SovGVD/esp32-legged-robots-core/src/web/docs/phone-status.png

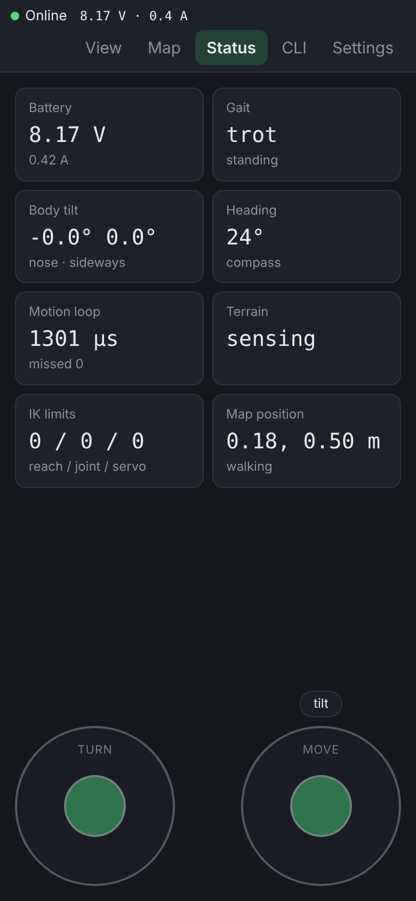
src/web/docs/phone-status.png
