SovGVD/esp32-legged-robots-core/cad/hexapod/hexapod.FCStd

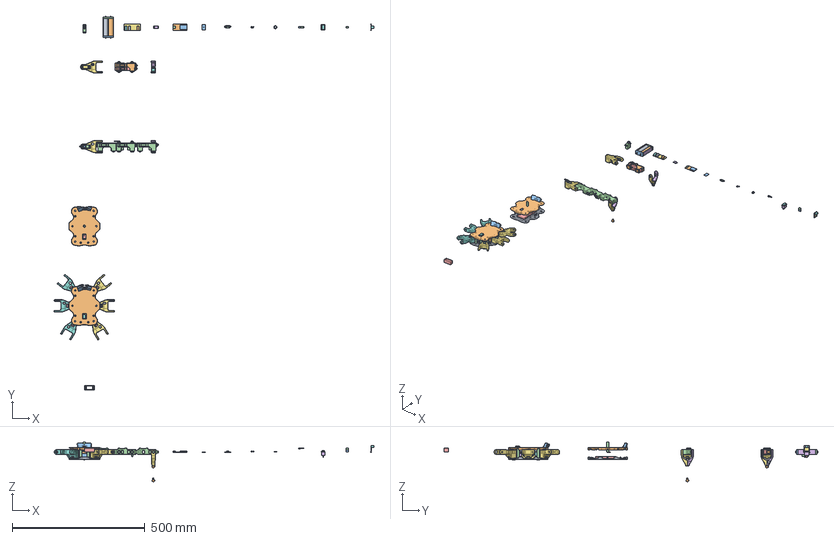
[picture p9: CAD file, 2026-11-13]
cad/hexapod/hexapod.FCStd
1204.8 x 1409.5 x 149.9 mm
_18650_pair_left x 2
_18650_pair_right x 2
_18650_pair_end_a x 2
_18650_pair_end_b x 2
_18650_pair_side_l x 2
_18650_pair_side_r x 2
_18650_pair_tab_al x 2
_18650_pair_tab_bl x 2
_18650_pair_tab_ar x 2
_18650_pair_tab_br x 2
GY91_pcb x 2
GY91_imu x 2
VL53L5CX_pcb x 3
VL53L5CX_ear_a x 3
VL53L5CX_hole_a x 3
VL53L5CX_ear_b x 3
VL53L5CX_hole_b x 3
VL53L5CX_pin_row x 3
VL53L5CX_cover_base x 3
VL53L5CX_sensor x 3
VL53L5CX_back_parts x 3
Microswitch_body x 2
Microswitch_button x 2
Microswitch_lead_a x 2
Microswitch_lead_b x 2
ESP32_devkit_pcb x 2
ESP32_devkit_module x 2
ESP32_devkit_usb x 2
Mini360_pcb
Mini360_components
PCA9685_pcb x 3
PCA9685_pins_1 x 3
PCA9685_pins_2 x 3
PCA9685_pins_3 x 3
PCA9685_tape_a x 3
PCA9685_mini_a x 3
PCA9685_comp_a x 3
PCA9685_tape_b x 3
PCA9685_mini_b x 3
PCA9685_comp_b x 3
PCA9685_tape_c x 3
PCA9685_mini_c x 3
PCA9685_comp_c x 3
MG90S_body x 11
MG90S_tabs x 11
MG90S_turret x 11
MG90S_shaft x 11
Bearing_ring x 11
Bearing_bore x 11
Bearing_body x 11
Horn_hub x 11
Horn_arm x 11
Horn_tip x 11
Rocker_body x 2
Rocker_bezel x 2
Rocker_rocker x 2
Rocker_pin_a x 2
Rocker_pin_b x 2
XT30_male x 2
XT30_female x 2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
