SovGVD/esp32-legged-robots-core/cad/hexapod/print/fit_test.stl

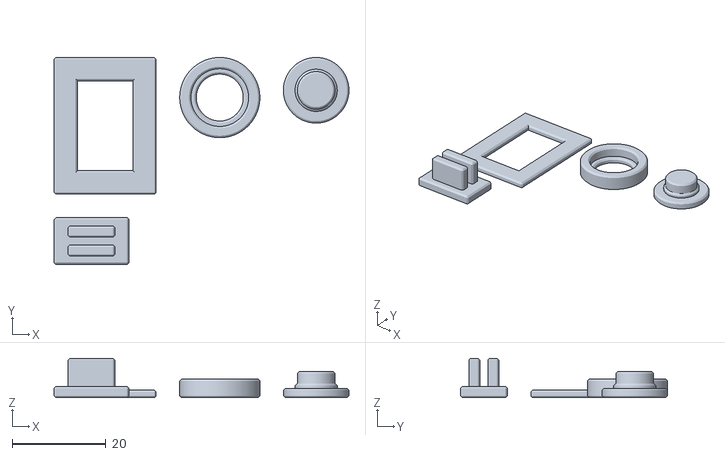
[picture p10: CAD file, 2026-11-06]
cad/hexapod/print/fit_test.stl
62.9 x 44.2 x 8.40
