SovGVD/esp32-legged-robots-core/sim/models/meshes/hexapod/coxa_L.stl

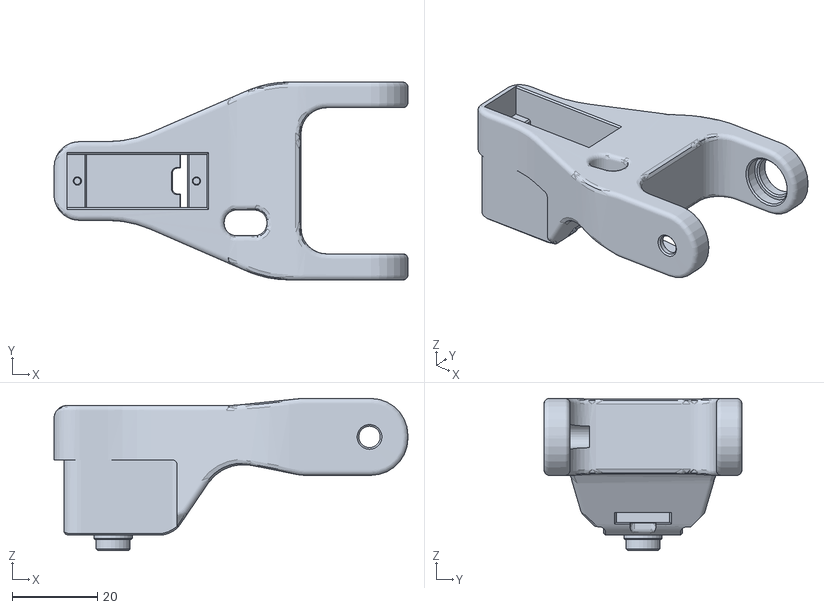
[picture p11: CAD file, 2026-11-13]
sim/models/meshes/hexapod/coxa_L.stl
82.8 x 46.3 x 35.6
