SovGVD/esp32-legged-robots-core/sim/models/meshes/leg_shoes_print_with_flexible.stl

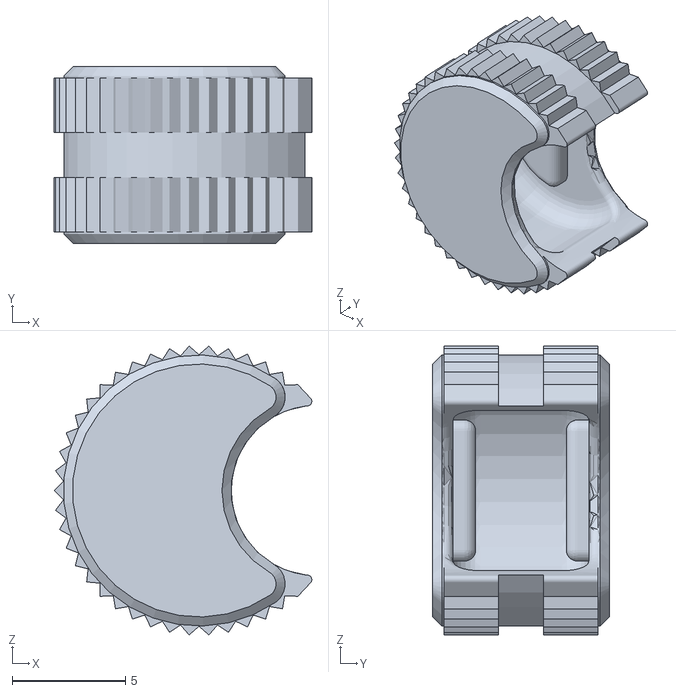
[picture p12: CAD file, 2026-11-02]
sim/models/meshes/leg_shoes_print_with_flexible.stl
11.4 x 7.80 x 12.8
