SovGVD/esp32-legged-robots-core/cad/hexapod/print/fit_test_servo.stl

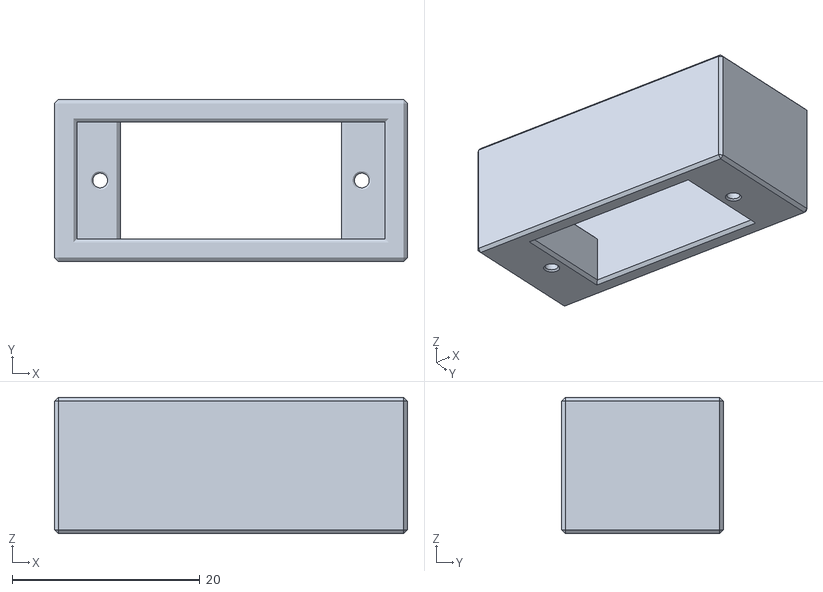
[picture p13: CAD file, 2026-11-06]
cad/hexapod/print/fit_test_servo.stl
37.6 x 17.2 x 14.5
