SovGVD/esp32-legged-robots-core/sim/models/meshes/body.stl

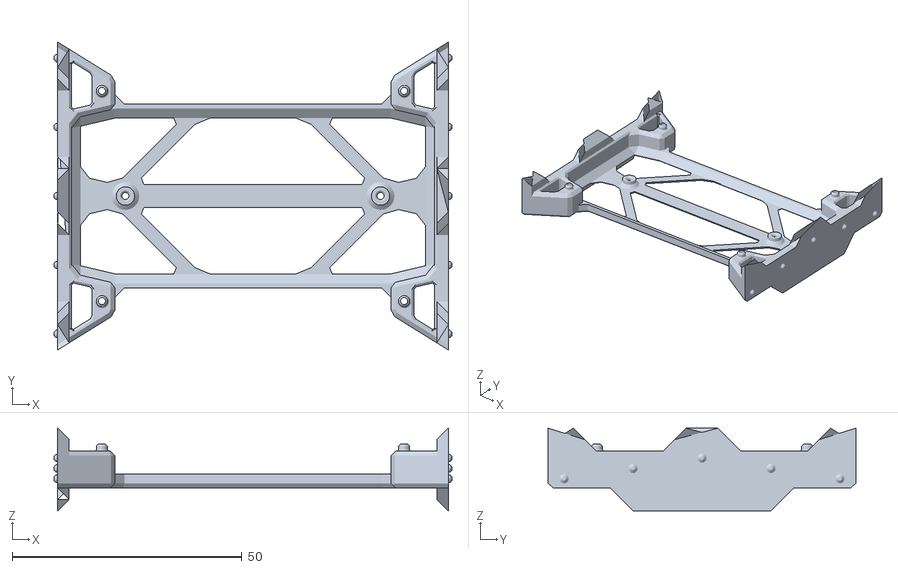
[picture p14: CAD file, 2026-11-02]
sim/models/meshes/body.stl
86.6 x 67.0 x 18.0
