SovGVD/esp32-legged-robots-core/sim/models/meshes/hexapod/torso_parts.stl

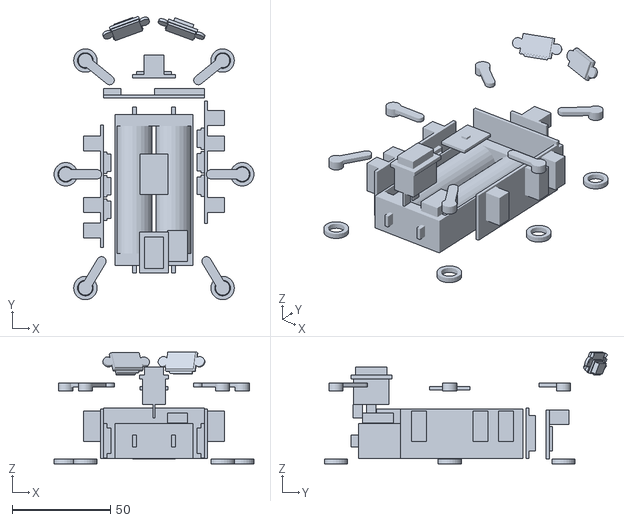
[picture p15: CAD file, 2026-11-13]
sim/models/meshes/hexapod/torso_parts.stl
102.0 x 144.5 x 57.0
