SovGVD/esp32-legged-robots-core/sim/models/meshes/shoulder_part2.stl

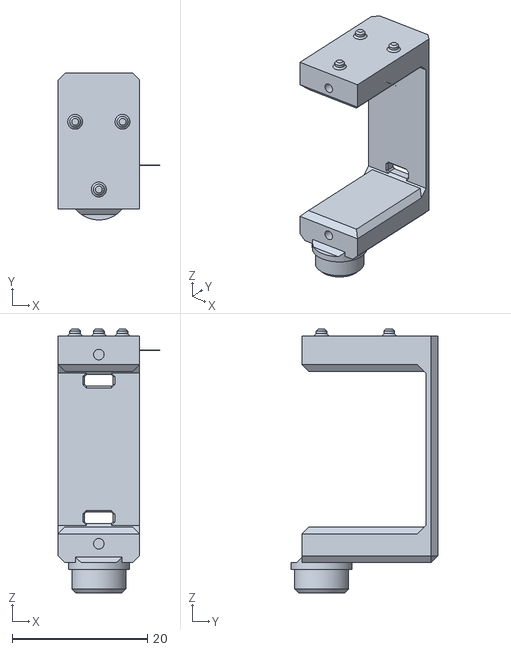
[picture p16: CAD file, 2026-11-02]
sim/models/meshes/shoulder_part2.stl
15.0 x 21.7 x 39.0
