SovGVD/esp32-legged-robots-core/sim/models/meshes/hexapod/coxa_servo_R.stl

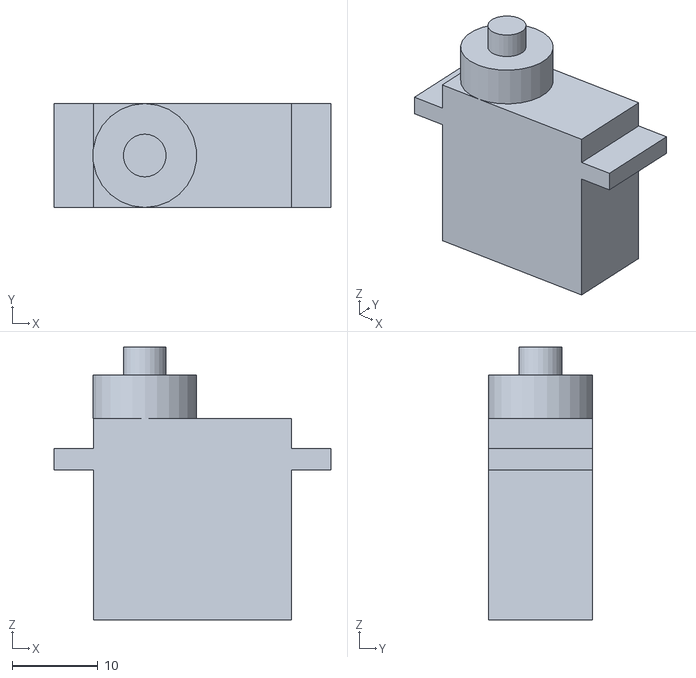
[picture p17: CAD file, 2026-11-13]
sim/models/meshes/hexapod/coxa_servo_R.stl
32.4 x 12.1 x 31.9
