SovGVD/esp32-legged-robots-core/sim/models/meshes/leg_top.stl

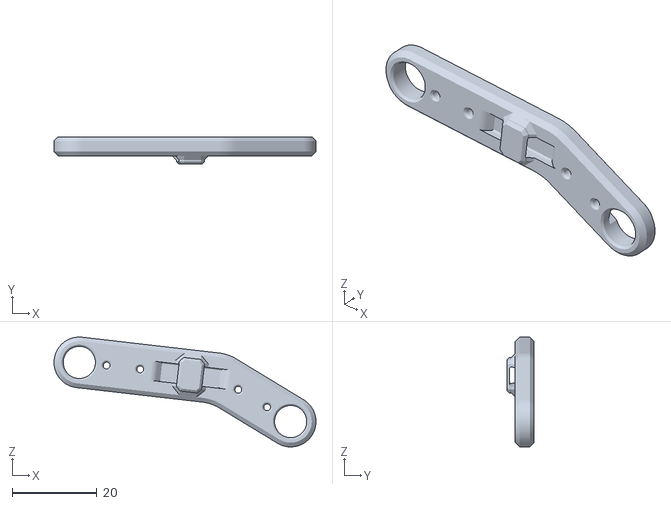
[picture p18: CAD file, 2026-11-02]
sim/models/meshes/leg_top.stl
62.0 x 6.50 x 26.0
