SovGVD/esp32-legged-robots-core/sim/models/meshes/hexapod/torso_top.stl

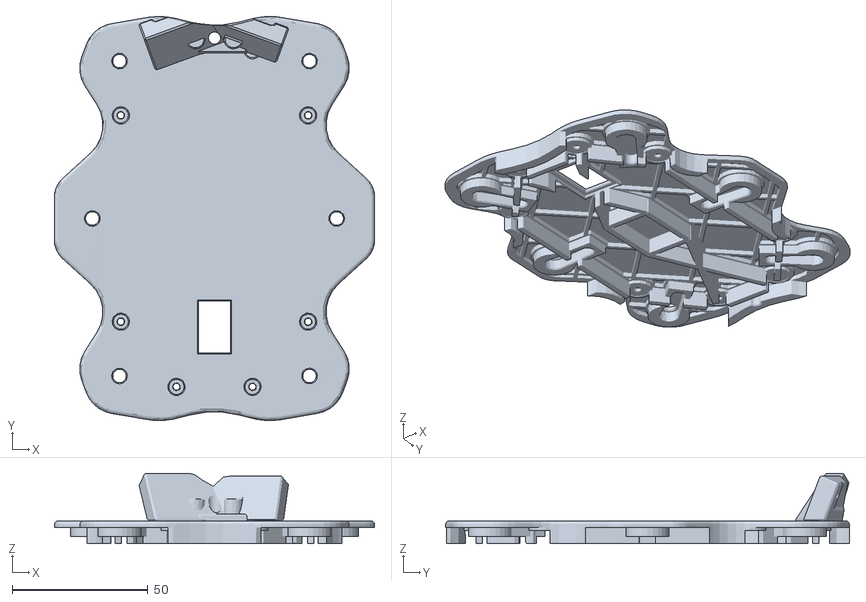
[picture p19: CAD file, 2026-11-13]
sim/models/meshes/hexapod/torso_top.stl
118.0 x 148.8 x 25.8
