SovGVD/esp32-legged-robots-core/sim/models/meshes/hexapod/torso_bottom.stl

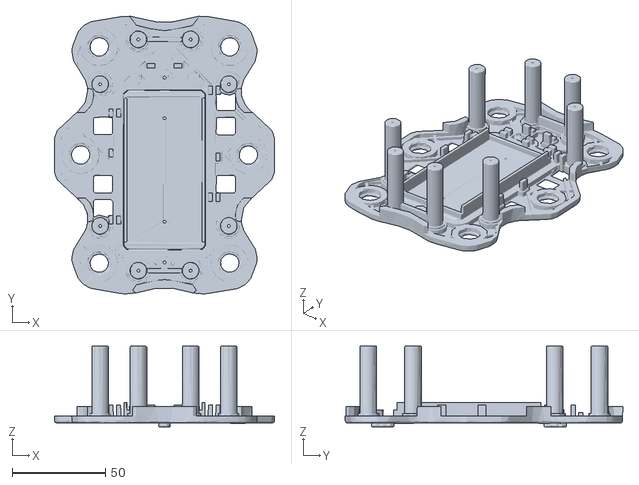
[picture p20: CAD file, 2026-11-13]
sim/models/meshes/hexapod/torso_bottom.stl
118.1 x 149.1 x 43.4
