SovGVD/esp32-legged-robots-core/sim/models/meshes/hexapod/femur_servos_R.stl

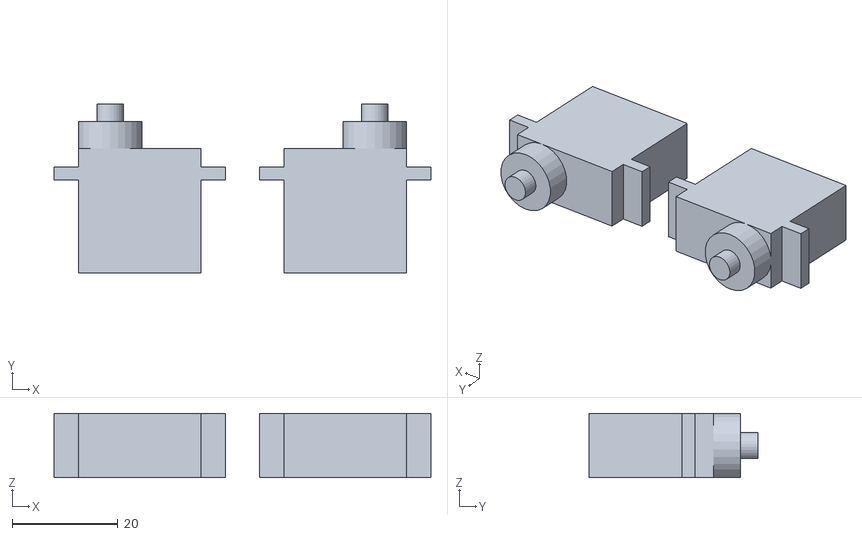
[picture p21: CAD file, 2026-11-13]
sim/models/meshes/hexapod/femur_servos_R.stl
71.2 x 31.9 x 12.1
