SovGVD/esp32-legged-robots-core/sim/models/meshes/hexapod/femur_L.stl

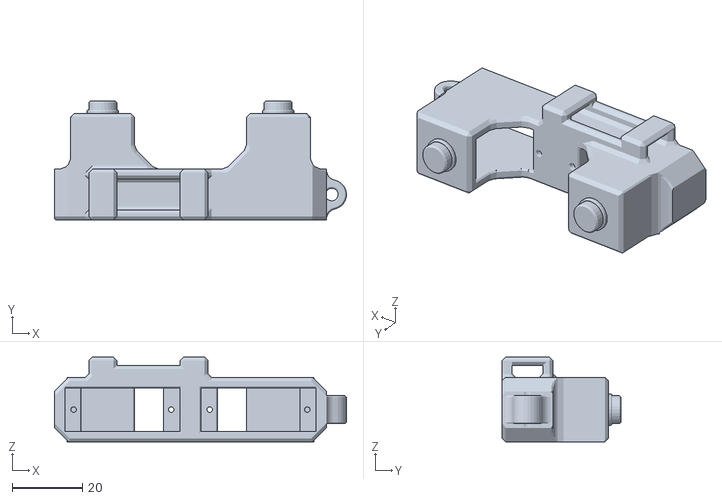
[picture p22: CAD file, 2026-11-13]
sim/models/meshes/hexapod/femur_L.stl
83.3 x 33.9 x 24.2
