SovGVD/esp32-legged-robots-core/sim/models/meshes/hexapod/tibia_L.stl

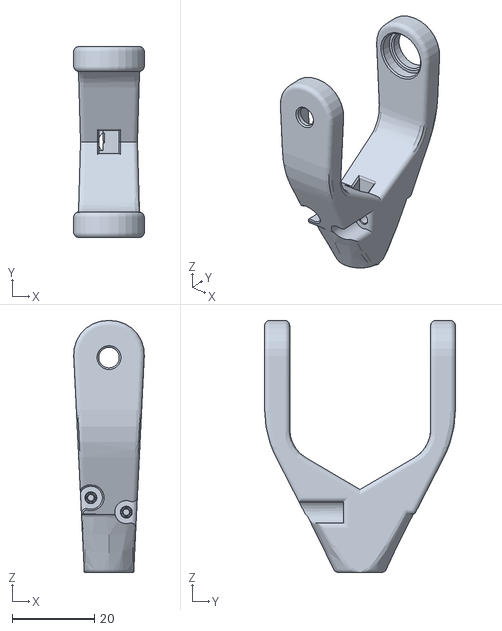
[picture p23: CAD file, 2026-11-13]
sim/models/meshes/hexapod/tibia_L.stl
17.2 x 46.3 x 61.2
