SovGVD/esp32-legged-robots-core/sim/models/meshes/hexapod/presser.stl

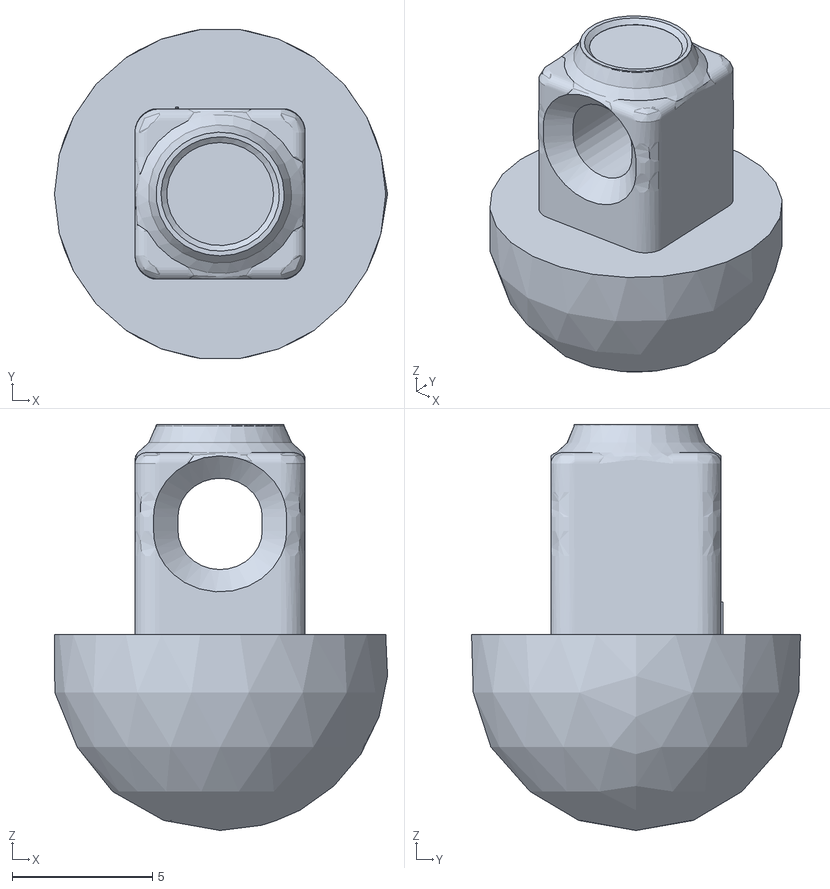
[picture p24: CAD file, 2026-11-08]
sim/models/meshes/hexapod/presser.stl
11.9 x 11.7 x 14.5
