SovGVD/esp32-legged-robots-core/sim/models/meshes/hexapod/coxa_gear.stl

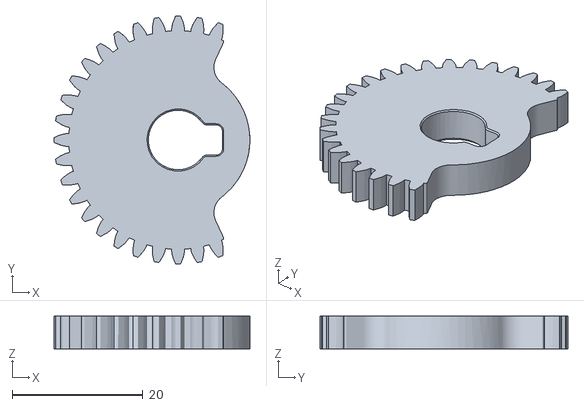
[picture p25: CAD file, 2026-11-03]
sim/models/meshes/hexapod/coxa_gear.stl
30.0 x 38.0 x 5.00
