SovGVD/esp32-legged-robots-core/(list of files, cad)

Other CAD files:
sim/models/meshes/hexapod/coxa_R.stl
sim/models/meshes/hexapod/coxa_servo_L.stl
sim/models/meshes/hexapod/femur_servos_L.stl
sim/models/meshes/hexapod/tibia_R.stl
sim/models/meshes/hexapod/femur_R.stl
