SovGVD/esp32-legged-robots-core/src/esp32-legged-robot/esp32-legged-robot.ino

#include <math.h>

#include "libraries/geometry/geometry.h"
#include "libraries/leg/leg.h"
#include "libraries/transition/transition.h"
#ifdef HORIZON_LEVEL
	#include "libraries/PID/AnglePID.h"
#endif
#include "def/def.h"
#include "def/cli.h"
#include "def/subscription.h"
#include "config.h"
#include "config_model.h"
#include "model/model.h"
#include "config_wifi.h"
#include "model/gait.h"
#include "model/settings.h"
#include "libraries/planner/planner.h"
#include "libraries/balance/balance.h"
#include "libraries/HAL_body/HAL_body.h"

#include <EEPROM.h>
#include <WiFi.h>
#include <WiFiClient.h>
#include <WiFiAP.h>
#include <DNSServer.h>
#include "ESPAsyncWebServer.h"
#include "web/index.html.gz.h"

#include <MPU9250_WE.h>
#include <Wire.h>

#include "libraries/PID/AnglePID.cpp"
#include "libraries/transition/transition.cpp"
#include "libraries/planner/planner.cpp"
#include "libraries/balance/balance.cpp"
#include "libraries/gait/gait.cpp"
#include "libraries/HAL_body/HAL_body.cpp"

#include "libraries/cliStream/cliStream.h"
#include "libraries/cliStream/cliStream.cpp"

#ifdef IGNORE_BROWNOUT_CONDITION
	#include "soc/soc.h"           // Disable brownour problems
	#include "soc/rtc_cntl_reg.h"  // Disable brownour problems
#endif

/**
 * Hardware libraries
 */
#if PWM_CONTROLLER_TYPE == PCA9685
  #include <Adafruit_PWMServoDriver.h>
#endif

#if PWM_CONTROLLER_TYPE == ESP32PWM
  #define USE_ESP32_TIMER_NO 0
  #include "ESP32_ISR_Servo.h"
#endif

#ifdef POWER_SENSOR
  float voltage_V = 0.0;
  float current_A = 0.0;

  #if POWER_SENSOR == INA219
    #include <INA219_WE.h>
    INA219_WE ina219;
  #endif
#endif

LR_angle IMU_DATA = {0, 0, 0};
MPU9250_WE IMU;

TaskHandle_t core0tasks;

#if PWM_CONTROLLER_TYPE == PCA9685
  Adafruit_PWMServoDriver pwm;
#endif

unsigned long currentTime;
unsigned long previousTime;
unsigned long loopTime;

unsigned long serviceCurrentTime;

unsigned long servicePreviousTime;
unsigned long serviceLoopTime;

unsigned long serviceFastPreviousTime;
unsigned long serviceFastLoopTime;

bool HALEnabled = true;

uint16_t servoPulse[LEG_NUM][LEG_DOF];

// Gait
uint16_t ticksPerGaitItem    = 0;
uint16_t ticksToNextGaitItem = 0;
uint8_t  currentGait         = 0;
uint8_t  nextGait            = 0;
double   gaitItemProgress    = 0;

transition bodyTransition;
transitionParameters bodyTransitionParams = {{0,0,0}, {0,0,0}, 0};

//Move
LR_moveVector vector = {
  {0, 0, 0},
  {0, 0, 0}
};

//Failsafe
bool FS_FAIL = false;
uint8_t FS_WS_count = 0;

// HAL
LR_figure body = {
  {  0,  0,  0},
  {  0,  0,  0}
};


LR_point bodyBalanceOffset = {0, 0, 0};

IK ikLeg(
	vector,
	body,
	bodyBalanceOffset,
	legs
);

gait gaitLeg(
	GAIT_CONFIG,
	legs
);


/* We need predict future position of legs/body */
planner walkPlanner(
	vector,
	body,
	legs
);

/* and balance it someway */
balance bodyBalance(
	body,
	legs
);

// IMU+PID
LR_angle imuCorrection = {0.0, 0.0, 0.0};
LR_angle imuTarget     = {0.0, 0.0, 0.0};

#ifdef HORIZON_LEVEL
	AnglePID imuCorrectionPID(IMU_DATA, imuTarget, imuCorrection, PID_LEVEL_P, PID_LEVEL_I, PID_LEVEL_D, -0.2, 0.2);
#endif

HAL_body bodyUpdate(vector, imuCorrection, body, legs);

// WebServer
IPAddress apIP(192,168,1,1);
IPAddress apGateway(192,168,1,1);
IPAddress apSubnet(255,255,255,0);
bool clientOnline = false;
AsyncWebSocketClient * wsclient;
int WiFiMode = AP_MODE;
IPAddress WiFiIP;
AsyncWebServer server(80);
AsyncWebSocket ws("/ws");
uint8_t telemetryPackage[P_TELEMETRY_LEN];

// DNS server
//const byte DNS_PORT = 53;
//DNSServer dnsServer;

#ifdef ESP32CAMERA
	#define CAMERAENABLED
	#include <esp32camera.h>
	esp32camera mainCamera;//(wsclient, ESP32CAMERA_FRAMESIZE, ESP32CAMERA_FPS, ESP32CAMERA_JPEG_QUALITY);
	bool mainCameraStream = false;
#endif

// CLI
cliStream *cliSerial;
cliStream cliStreamObj;

// Settings
modelSettings settings;

bool robotLoopReady   = false;
bool serviceLoopReady = false;
bool isHalDoReady     = false;

void robotSetup()
{
	if (!robotLoopReady) {
		Wire.begin(I2C_SDA, I2C_SCL);
		Wire.setClock(400000);
		vTaskDelay(100);

		initServo();

		initHAL();
		vTaskDelay(100);

		initGait();
		vTaskDelay(100);

		initIMU();
		vTaskDelay(100);

		initPowerSensor();
		vTaskDelay(100);

		robotLoopReady = true;
		Serial.println("MainSetup complete");
	}
}

void servicesSetup()
{
	if (!serviceLoopReady) {
		initServo();
		vTaskDelay(100);

		initCLI();
		vTaskDelay(100);
		
		initWiFi();
		vTaskDelay(100);

		initWebServer();
		vTaskDelay(100);

		#ifdef ESP32CAMERA
			mainCamera.setup(
				ESP32CAMERA_FRAMESIZE,
				ESP32CAMERA_FPS,
				ESP32CAMERA_JPEG_QUALITY
			);
		#endif

		Serial.println("ServicesSetup complete");
		serviceLoopReady = true;
	}
}

/**
 * Everything related to robot-only code: i2c, servos, imu, etc
 */
void robotLoop()
{
	currentTime = micros();
	if (currentTime - previousTime >= LOOP_TIME) {
		previousTime = currentTime;

		updateFailsafe();
		updatePower();  // TODO not so often!

		#ifdef HORIZON_LEVEL
			updateIMU();
			imuCorrectionPID.update();
		#endif
		if (!isHalDoReady) {
			updateGait();
			updateHAL();
			isHalDoReady = true;
		}
		#if DO_HAL_CORE == 1
			doHAL();
		#endif

		//CLI_doCommand();

		FS_WS_count++;

		loopTime = micros() - currentTime;
		if (loopTime > LOOP_TIME) {
			Serial.print("WARNING! Increase LOOP_TIME: ");
			Serial.println(loopTime);
		}
	}
}

/**
 * WiFi, WebServer, Cli and other bells and whistles
 */
void servicesLoop() {
	serviceCurrentTime = micros();

	#ifdef CAMERAENABLED
		if (clientOnline && mainCameraStream) {
			mainCamera.processFrame();
		}
	#endif
	
	/**
	 * @TODO this to actually kind of wrong as first IF will slow down second IF and so on =(
	 */

	if (serviceCurrentTime - serviceFastPreviousTime >= LOOP_TIME) {
		serviceFastPreviousTime = serviceCurrentTime;

		#if DO_HAL_CORE == 0
			doHAL();
		#endif

		serviceFastLoopTime = micros() - serviceCurrentTime;
		if (serviceFastLoopTime > LOOP_TIME) {
			Serial.print("WARNING! Increase SERVICE_FAST_LOOP_TIME: ");
			Serial.println(serviceFastLoopTime);
		}
	}

	if (serviceCurrentTime - servicePreviousTime >= SERVICE_LOOP_TIME) {
		servicePreviousTime = serviceCurrentTime;

		updateCLI();
		CLI_doCommand();

		serviceLoopTime = micros() - serviceCurrentTime;
		if (serviceLoopTime > SERVICE_LOOP_TIME) {
			Serial.print("WARNING! Increase SERVICE_LOOP_TIME: ");
			Serial.println(serviceLoopTime);
		}
	}
}

/**
   TODO
    - calculate center of mass and use it for balance
*/

void setup()
{
	#ifdef IGNORE_BROWNOUT_CONDITION
		WRITE_PERI_REG(RTC_CNTL_BROWN_OUT_REG, 0); //disable brownout detector
	#endif
	Serial.begin(SERIAL_BAUD);
	cliStreamObj.setStreamPrefix(P_CLI);
	cliStreamObj.setClient(wsclient);
	cliSerial = &cliStreamObj;

	initSettings();
	vTaskDelay(100);

	robotSetup();
	vTaskDelay(10);

	xTaskCreatePinnedToCore(
		core0loop,      /* Task function. */
		"core0loop",    /* name of task. */
		100000,         /* Stack size of task */
		NULL,           /* parameter of the task */
		0,              /* priority of the task */
		&core0tasks,    /* Task handle to keep track of created task */
		0);             /* pin task to core 0 */
}

/**
 * Core 1
 */
void loop()
{
	if(robotLoopReady && serviceLoopReady) {
		//dnsServer.processNextRequest();
		robotLoop();
	}
}

/**
 * Core 0
 */
void core0loop(void * pvParameters) {
	if (robotLoopReady) {
		servicesSetup();
	}

	while(robotLoopReady && serviceLoopReady) {
		servicesLoop();
		vTaskDelay(1);
	}

	vTaskDelay(100);
}
