SovGVD/esp32-legged-robots-core/cad/hexapod/build_coxa.py

"""The coxa link: one print carrying the coxa servo. A real shape, not stacked boxes: from
above a horseshoe, round around the coxa axis and curving out to the fork around the
femur; from the side an arch under it. The servo sits in a pocket cut into that.

The servo's horn fixes to the body's top plate. A floor under the servo carries a shaft
that runs in the bearing in the body's bottom plate. Horns are glued into their pockets.
In the fork the femur servo's horn sits in the +Y arm and the femur's shaft runs in a bearing in the -Y arm. The cables of
the femur's 2 servos and the foot switch go down a hole through the coxa, beside the servo, to where the coxa servo's own
cable comes out under the coxa (the servo's pocket opens through the arch there); the 4 are zip-tied together there.

The -Y (bearing) side is a separate print, screwed on with 2 stock MG90S screws like the
tibia halves: a one-piece fork can't take the femur, whose spline and shaft both point
outward. It comes off on a plane next to the servo (coxa_cut_y) from coxa_cut_x out, a
plate printed on its outer face; the coxa prints on its +Y face. From above the coxa is symmetric: the bearing
side curves out like the horn side, the plate continuing the curve. Underneath it tapers like a keel. The screw heads sit 2 mm over the joint face. Assembly: glue the
horn into the +Y arm, put the bearing on the femur's shaft in the loose side, push the
femur's servo onto the horn, then screw the side on.

  Coxa_Body  the coxa with the servo and the +Y (horn) arm
  Coxa_Arm   the -Y (bearing) side
  Coxa_Main  both together, for the checks, the body and the FEA

Right leg; Coxa_Main_L is the left leg's. Leg frame: origin on the coxa axis at femur axis
height, +X out along the link, Z up. Sizes come from Params when this script runs:
re-run it after changing them.
"""
import os
import runpy

import FreeCAD as App
import Part

HERE = os.path.dirname(os.path.abspath(__file__))
common = runpy.run_path(os.path.join(HERE, "common.py"))
doc = common["get_doc"]()
PLA = (0.88, 0.63, 0.11)
SERVO_ROT = App.Rotation(App.Vector(0, 0, 1), 90)       # servo Y to -X: its body runs toward +X, shaft up
HORN_IN = App.Rotation(App.Vector(0, 0, 1), 180)        # coxa horn arm toward the body
KNEE = App.Rotation(App.Matrix(0, 1, 0, 0,  0, 0, 1, 0,  1, 0, 0, 0,  0, 0, 0, 1))
FEMUR_HORN = KNEE.multiply(App.Rotation(App.Vector(0, 0, 1), -90))
HIP_SERVO = KNEE.multiply(App.Rotation(App.Vector(0, 0, 1), 180))
BEARING_ALONG_Y = App.Rotation(App.Vector(1, 0, 0), -90)
S = doc.getObject("Params")


def v(alias):
    x = S.get(alias)
    return float(getattr(x, "Value", x))


common["remove_built"](doc, ("CoxaCheck", "CoxaPrim", "Coxa"))
part = doc.addObject("App::Part", "Coxa")
part.setExpression("Placement.Base.y", "Params.catalog_row2_y")
check = doc.addObject("App::Part", "Coxa_Check")
check.setExpression("Placement.Base.y", "Params.catalog_row2_y * 3")
prism, block, rod = common["prism"], common["block"], common["rod"]

fl = v("coxa_len")
arm_r = v("coxa_arm_w") / 2
end_x = fl + arm_r
a_y0, a_y1 = v("coxa_arm_a_y0"), v("coxa_arm_a_y1")
b_y1 = v("coxa_arm_b_y1")
b_y0 = v("coxa_arm_b_y0")
rear, side_y, rear_r = v("coxa_tail_x"), v("coxa_side_y"), v("coxa_rear_corner_r")
waist_x, waist_r = v("coxa_waist_x"), v("coxa_waist_r")
fork_x = v("coxa_cross_x1")
fork_r = v("coxa_fork_r")
z0, z1 = v("coxa_plate_z0"), v("coxa_plate_z1")
floor_z0 = v("coxa_floor_z0")
floor_in = floor_z0 + v("coxa_floor_t")
seat = v("coxa_seat_z")

# the horseshoe from above: around the servo only a wall wide (the rest of the coxa takes the load)
straight = v("coxa_straight_x")
cut_x, cut_y = v("coxa_cut_x"), v("coxa_cut_y")
# symmetric from above: the bearing side curves out to the fork's width like the horn side, by waist_x
above = prism([(-rear, side_y, rear_r), (straight, side_y, 25), (waist_x, a_y1, 25), (end_x, a_y1, 0), (end_x, a_y0, 0), (fork_x, a_y0, fork_r),
               (fork_x, b_y1, fork_r), (end_x, b_y1, 0), (end_x, b_y0, 0), (waist_x, b_y0, 25), (straight, -side_y, 25), (-rear, -side_y, rear_r)],
              "xy", floor_z0 - 1, arm_r + 1)
# the arch from the side, with a round end around the femur axis
side = prism([(-rear, z1, 3), (v("coxa_top_x"), z1, 20), (fork_x, arm_r, 20), (end_x, arm_r, arm_r), (end_x, -arm_r, arm_r),
              (fork_x, -arm_r, 12), (v("coxa_arch_x1"), z0, 10), (v("coxa_arch_x0"), floor_z0, 6), (-rear, floor_z0, 4)],
             "xz", b_y0 - 1, a_y1 + 1)
shape = above.common(side).removeSplitter()

# ------------------------------------------------------------ cut the pockets into it
fit = v("mg90_fit")
hw = v("mg90_body_w") / 2 + v("mg90_fit_w")
near = v("mg90_shaft_end") + fit
far = v("mg90_body_len") - v("mg90_shaft_end") + fit
tab_near = v("mg90_tab_near") + fit
tab_far = v("mg90_tab_far") + fit
tip_w = v("horn_tip_w")
pocket = v("horn_hub_h") + v("horn_fit")      # the horn plus a little room for glue
arm = v("horn_reach") - tip_w / 2
through = a_y1 - a_y0 + 1
horn_way = pocket + 0.3                       # the horn's way in, in front of its pocket
cuts = [
    block(-near, far, -hw, hw, floor_in, z1 + 1),                # the servo's body, down to the floor
    # the servo's cable leaves the bottom of its far end: a slot through the floor there takes it down and out
    # under the coxa, so it isn't trapped under the servo (as in the femur, print 1)
    block(far - v("coxa_cable_slot_x"), far, -v("coxa_cable_slot_w") / 2, v("coxa_cable_slot_w") / 2, floor_z0 - 10, floor_in + 1),
    block(-tab_near, tab_far, -hw, hw, seat, z1 + 1),            # its tabs
    rod(v("mg90_screw_pilot_d"), v("coxa_plate_floor") + 1, (-v("mg90_hole_near"), 0, z0 - 1), "z"),
    rod(v("mg90_screw_pilot_d"), v("coxa_plate_floor") + 1, (v("mg90_hole_far"), 0, z0 - 1), "z"),
    # the femur servo's horn, its arm toward the coxa axis
    common["horn_pocket"](v("horn_pocket_d") / 2, v("horn_pocket_w") / 2, arm, pocket, (fl, a_y0, 0), (-1, 0, 0), (0, 1, 0)),
    # its way in: the arm's tip lies under the fork's crotch, so the same outline goes one layer deeper into
    # the crotch. The horn slides in from the open end of the fork, then sideways into its pocket.
    common["horn_pocket"](v("horn_pocket_d") / 2, v("horn_pocket_w") / 2, arm, horn_way + 0.01, (fl, a_y0 - horn_way, 0),
                          (-1, 0, 0), (0, 1, 0)),
    rod(5.0, through, (fl, a_y0, 0), "y"),
    # the femur's bearing
    rod(v("bearing_seat_d"), b_y1 - v("tib_bear_seat_end") + 1, (fl, v("tib_bear_seat_end"), 0), "y"),
    rod(v("bearing_push_d"), v("tib_bear_roof") + 1, (fl, b_y0 - 1, 0), "y"),
]
# the femur's cables go down a hole through the coxa, beside the servo, to the coxa servo's cable under it
h_x0, h_x1 = v("coxa_hole_x0"), v("coxa_hole_x1")
h_r = v("coxa_hole_w") / 2
h_y = v("coxa_hole_y")
hole = prism([(h_x0, h_y - h_r, h_r - 0.01), (h_x1, h_y - h_r, h_r - 0.01), (h_x1, h_y + h_r, h_r - 0.01), (h_x0, h_y + h_r, h_r - 0.01)],
             "xy", z0 - 5, arm_r + 2)
cuts.append(hole)
# solid otherwise: the slicer's infill fills it, with no overhangs inside to support
# (the -Y side is solid behind the bearing arm's joint face this far, for its screws)
j_y = v("coxa_joint_y")
# under the plate the rear is narrower: it swings next to the board's pins
skirt = block(-rear - 1, v("coxa_arch_x0") + 1, -rear - 8, rear + 8, floor_z0 - 2, z0).cut(
    prism([(-v("coxa_skirt_x"), 9.2, 4), (v("coxa_arch_x0") + 2, 9.2, 0), (v("coxa_arch_x0") + 2, -9.2, 0), (-v("coxa_skirt_x"), -9.2, 4)], "xy", floor_z0 - 3, z0 + 1))
cuts.append(skirt)
# seen from the fork end the underside tapers like a keel: from the fork arms' outer faces at z ~-9 down to
# the floor's width at its bottom, both sides alike (print 1 feedback: the flare's low part looked like a triangle)
k_top, k_bot = v("coxa_keel_top_z"), floor_z0
k_y1 = max(abs(a_y1), abs(b_y0))
for sgn in (1, -1):
    cuts.append(prism([(sgn * k_y1, k_top, 0), (sgn * side_y, k_bot, 0), (sgn * side_y, k_bot - 20, 0), (sgn * (k_y1 + 20), k_bot - 20, 0),
                       (sgn * (k_y1 + 20), k_top, 0)], "yz", -rear - 2, end_x + 2))
shape = shape.cut(Part.makeCompound(cuts)).removeSplitter()
# the shaft under the floor, on its spacer
shaft = rod(v("fem_boss_d"), v("fem_boss_h"), (0, 0, floor_z0 - v("fem_boss_h")), "z").fuse(
    rod(v("coxa_shaft_d"), v("fem_shaft_len"), (0, 0, floor_z0 - v("fem_boss_h") - v("fem_shaft_len")), "z"))
shape = shape.fuse(shaft).removeSplitter()
print("raw solids", len(shape.Solids), shape.isValid())

# ------------------------------------------------------------ round the outer edges


def keep_sharp(e):
    bb = e.BoundBox
    servo = abs(bb.YMin) <= hw + 0.2 and abs(bb.YMax) <= hw + 0.2 and bb.ZMin >= floor_in - 0.2 and bb.XMin >= -tab_near - 0.2 and bb.XMax <= tab_far + 0.2
    horn = bb.YMin >= a_y0 - horn_way - 0.1 and bb.YMax <= a_y0 + pocket + 0.1 and bb.XMin >= fl - v("horn_reach") - 0.2
    bearing = bb.YMax < b_y1 + 0.1 and abs(bb.XMin - fl) <= 7 and abs(bb.XMax - fl) <= 7 and abs(bb.ZMin) <= 7 and abs(bb.ZMax) <= 7
    in_hole = bb.XMin >= h_x0 - 0.2 and bb.XMax <= h_x1 + 0.2 and bb.YMin >= h_y - h_r - 0.2 and bb.YMax <= h_y + h_r + 0.2
    small_round = e.Curve.TypeId == "Part::GeomCircle" and e.Curve.Radius < 5 and not in_hole
    shaft_area = bb.ZMax <= floor_z0 + 0.1 and abs(bb.XMin) < 6 and abs(bb.XMax) < 6
    return servo or horn or bearing or small_round or shaft_area


# the top edges along both sides' curves get a bigger round than the rest of the outline (the kernel
# refuses large ones there: they run into the rising top past x 26)
flare_edges = [e for e in shape.Edges if e.BoundBox.ZLength < 0.01 and abs(e.BoundBox.ZMin - z1) < 0.01 and (e.BoundBox.YMax < -9.0 or e.BoundBox.YMin > 9.0)]
for r_ in (v("coxa_flare_edge_r"), 2.0, 1.5):
    try:
        trial = shape.makeFillet(r_, flare_edges)
        if trial.isValid() and len(trial.Solids) == 1 and 0.97 * shape.Volume < trial.Volume <= shape.Volume:
            print("side top edges rounded r %.1f (%d edges)" % (r_, len(flare_edges)))
            shape = trial
            break
    except Exception:
        print("side top edges: r %.1f refused" % r_)
main_shape = common["smooth"](shape, v("coxa_edge_r"), keep_sharp)
# ------------------------------------------------------------ the bearing side comes off
# on the plane cut_y, from cut_x out: a plate with the bearing arm, printed on its outer face (flat from waist_x
# out; nearer the coxa it follows the outline's curve up off the bed). The coxa prints on its +Y (horn arm) face
side_box = block(cut_x, end_x + 5, b_y0 - 5, cut_y, -100, 100)
arm_shape = main_shape.common(side_box).removeSplitter()
body_shape = main_shape.cut(side_box).removeSplitter()
head_y = v("coxa_screw_head_y")                      # the head seats this far from the joint face
for x, z in ((v("coxa_screw_a_x"), v("coxa_screw_a_z")), (v("coxa_screw_b_x"), v("coxa_screw_b_z"))):
    arm_shape = arm_shape.cut(Part.makeCompound([
        rod(v("tib_screw_clear"), cut_y - b_y0 + 2, (x, b_y0 - 1, z), "y"),
        rod(v("tib_screw_head_d"), (cut_y - head_y) - b_y0 + 1, (x, b_y0 - 1, z), "y")]))
    body_shape = body_shape.cut(rod(v("tib_screw_d"), j_y - cut_y + 1, (x, cut_y - 1, z), "y"))


def joint_face(e):
    """Edges in the joint stay sharp (the pieces meet there), except the screw holes' mouths."""
    bb = e.BoundBox
    try:
        small_hole = e.Curve.TypeId == "Part::GeomCircle" and 2 * e.Curve.Radius <= v("lead_small_d") + 1e-6
    except Exception:
        small_hole = False
    on_y = bb.YLength < 1e-4 and abs(bb.YMin - cut_y) < 1e-4
    on_x = bb.XLength < 1e-4 and abs(bb.XMin - cut_x) < 1e-4 and bb.YMax <= cut_y + 1e-4
    return (on_y or on_x) and not small_hole


def shaft_or_joint(e):
    # the shaft and its spacer under the floor stay as they are: the spacer presses on the bearing's inner ring
    c = e.BoundBox.Center
    shaft = (c.x ** 2 + c.y ** 2) ** 0.5 <= v("fem_boss_d") / 2 + 0.2 and e.BoundBox.ZMax <= floor_z0 + 0.01
    return shaft or joint_face(e)


body_shape = common["lead_ins"](body_shape, v("lead_small"), v("lead_big"), v("lead_small_d"), shaft_or_joint)
arm_shape = common["lead_ins"](arm_shape, v("lead_small"), v("lead_big"), v("lead_small_d"), joint_face)
# the shaft's own chamfers: a lead-in on its tip (into the bearing), and only a small one on the spacer's
# outer edge, which must still bear on the inner ring (8 to 9 mm across, the ring's own bore chamfer eats the inner part)
spacer_z = floor_z0 - v("fem_boss_h")
tip_z = spacer_z - v("fem_shaft_len")


def ring_edge(r, z):
    for e in body_shape.Edges:
        if abs(e.BoundBox.ZMin - z) > 1e-4 or abs(e.BoundBox.ZMax - z) > 1e-4:
            continue
        try:
            c = e.Curve
            if c.TypeId == "Part::GeomCircle" and abs(c.Radius - r) < 1e-4 and abs(c.Center.x) < 1e-4 and abs(c.Center.y) < 1e-4:
                return e
        except Exception:                       # edges without a plain curve
            continue
    raise RuntimeError("no shaft edge r %.2f at z %.2f" % (r, z))


body_shape = body_shape.makeChamfer(v("lead_big"), [ring_edge(v("coxa_shaft_d") / 2, tip_z)])
body_shape = body_shape.makeChamfer(v("lead_small"), [ring_edge(v("fem_boss_d") / 2, spacer_z)])
# alignment pins on the bearing side's joint face, holes for them in the coxa: the bearing side prints on
# its outer face, pins up
arm_shape, body_shape, pin_sites = common["align_pins"](
    arm_shape, body_shape, [(v("coxa_pin_a_x"), v("coxa_pin_a_z")), (v("coxa_pin_b_x"), v("coxa_pin_b_z"))], cut_y, 1,
    v("align_pin_d"), v("align_pin_h"), v("align_hole_d"), v("align_hole_h"), v("align_hole_ch"), v("align_pin_ch"))
print("alignment pins, (hole site solid, pin base solid) each, 1.0 is good: %s" % pin_sites)
body = common["as_part"](doc, part, "Coxa_Body", body_shape, PLA)
arm_part = common["as_part"](doc, part, "Coxa_Arm", arm_shape, (0.95, 0.75, 0.3))
common["add_mirror"](doc, part, body, PLA)
common["add_mirror"](doc, part, arm_part, (0.95, 0.75, 0.3))
main_shape = Part.makeCompound([body_shape, arm_shape])
main = common["as_part"](doc, part, "Coxa_Main", main_shape, PLA)
common["add_mirror"](doc, part, main, PLA)
common["save"](doc)


def link(name, target, base, rot=None):
    obj = doc.addObject("App::Link", "CoxaCheck_" + name)
    check.addObject(obj)
    obj.LinkedObject = target
    obj.Placement = App.Placement(App.Vector(*base), rot or App.Rotation())
    return obj


bz = floor_z0 - v("fem_boss_h") - v("bearing_t")
link("main", main, (0, 0, 0))
link("servo", doc.getObject("Dummy_MG90S"), (0, 0, seat), SERVO_ROT)
link("horn", doc.getObject("Dummy_Horn"), (0, 0, seat), HORN_IN)
link("bearing", doc.getObject("Dummy_Bearing"), (0, 0, bz))
link("femur", doc.getObject("Femur_Main"), (fl, 0, 0))
common["save"](doc)

solids_of, clash = common["solids_of"], common["clash"]
SERVO = ["MG90S_body", "MG90S_tabs", "MG90S_turret", "MG90S_shaft"]
HORN = ["Horn_hub", "Horn_arm", "Horn_tip"]
Pl = lambda x, y, z, rot=None: App.Placement(App.Vector(x, y, z), rot or App.Rotation())
main_s = solids_of(doc, ["Coxa_Main"])
s_y = v("joint_seat_y")
b_y = v("fem_floor_y0") - v("fem_boss_h") - v("bearing_t")
bb = main_shape.BoundBox
print("coxa %.1f g solid (body %.1f, arm %.1f); valid %s %s; solids %d %d; x %.1f to %.1f, y %.1f to %.1f, z %.1f to %.1f" % (
    main_shape.Volume / 1000 * v("pla_density"), body_shape.Volume / 1000 * v("pla_density"), arm_shape.Volume / 1000 * v("pla_density"),
    body_shape.isValid(), arm_shape.isValid(), len(body_shape.Solids), len(arm_shape.Solids), bb.XMin, bb.XMax, bb.YMin, bb.YMax, bb.ZMin, bb.ZMax))
print("overlap mm3: body and arm %.3f" % clash(body_shape.Solids, arm_shape.Solids))
print("overlap mm3: coxa servo %.3f, coxa horn %.3f, coxa bearing %.3f, femur horn %.3f, femur bearing %.3f" % (
    clash(solids_of(doc, SERVO, Pl(0, 0, seat, SERVO_ROT)), main_s), clash(solids_of(doc, HORN, Pl(0, 0, seat, HORN_IN)), main_s),
    clash(solids_of(doc, ["Bearing_body"], Pl(0, 0, bz)), main_s),
    clash(solids_of(doc, HORN, Pl(fl, s_y, 0, FEMUR_HORN)), main_s),
    clash(solids_of(doc, ["Bearing_body"], Pl(fl, b_y, 0, BEARING_ALONG_Y)), main_s)))
fixed = {"coxa": main_s, "coxa servo": solids_of(doc, SERVO, Pl(0, 0, seat, SERVO_ROT))}
hits = {}
for deg in range(-90, 91, 10):
    swing = Pl(fl, 0, 0, App.Rotation(App.Vector(0, 1, 0), deg))
    moved = {"femur": solids_of(doc, ["Femur_Main"], swing),
             "hip servo": solids_of(doc, SERVO, swing.multiply(Pl(0, s_y, 0, HIP_SERVO))),
             "knee servo": solids_of(doc, SERVO, swing.multiply(Pl(v("femur_len"), s_y, 0, KNEE)))}
    for mname, group in moved.items():
        for fname, f in fixed.items():
            x = clash(group, f)
            if x > 0.001:
                hits.setdefault((mname, fname), []).append(deg)
print("femur sweep, angles that collide: %s" % (hits or "none"))
