SovGVD/esp32-legged-robots-core/src/esp32-legged-robot/model/settings.h

#ifndef MODEL_SETTINGS_H
#define MODEL_SETTINGS_H

#if ROBOT_MODEL == MODEL_DOG
  #include "dog/settings.h"
#endif

#if ROBOT_MODEL == MODEL_BIPED
  #include "biped/settings.h"
#endif

#if ROBOT_MODEL == MODEL_TANK
  #include "tank/settings.h"
#endif

#if ROBOT_MODEL == MODEL_HEXAPOD
  #include "hexapod/settings.h"
#endif

#endif
