SovGVD/esp32-legged-robots-core/src/esp32-legged-robot/model/cli.h

#if ROBOT_MODEL == MODEL_DOG
  #include "dog/cli.cpp"
#endif

#if ROBOT_MODEL == MODEL_BIPED
  #include "biped/cli.cpp"
#endif

#if ROBOT_MODEL == MODEL_TANK
  #include "tank/cli.cpp"
#endif

#if ROBOT_MODEL == MODEL_HEXAPOD
  #include "hexapod/cli.cpp"
#endif
