SovGVD/esp32-legged-robots-core/src/esp32-legged-robot/model/tank/settings.h

#define MODEL_SETTINGS_KEY 0x10CC   // Some magic UNQIE key to verify EEPROM
#define MAX_CPU_CORES      2

typedef struct {
	double alpha;
	double beta;
	double gamma;
} modelSettingsAngleTrim;

typedef struct {
	uint16_t               modelKey;
	uint8_t                structSize;
	modelSettingsAngleTrim trim[LEG_NUM];
} modelSettings;
