SovGVD/esp32-legged-robots-core/sim/legsim/scenario.py

"""
Walk a robot over a terrain with the firmware and measure how it went.

    from legsim.scenario import run
    r = run("dog", "bars", sensing="both")
    print(r.summary())

sensing: "none" (open loop, the real robots today), "contacts" (foot switches),
"tof" (ToF terrain map only), "both".
"""

import math
from dataclasses import dataclass, field

import numpy as np

from . import terrain as terrains
from .firmware import FirmwareCore
from .robot import SimDog

SENSING = {
    "none": dict(contacts=False, tof=False),
    "contacts": dict(contacts=True, tof=False),
    "tof": dict(contacts=False, tof=True),
    "both": dict(contacts=True, tof=True),
}

# per robot: gait, move command and scene sizes for terrain_walk.py and the tests
DEFAULTS = {
    "dog": {"gait": "rough", "speed": 1.0, "scale": 1.0},
    "hexapod": {"gait": "rough", "speed": 1.0, "scale": 1.5},   # higher than ~30 mm: femur servo range
    "hexapod2": {"gait": "rough", "speed": 1.0, "scale": 1.5},  # the new hexapod (new_body.py)
}


def scene(model, name, height=None):
    """A terrain scene sized for the robot (height: obstacle / bump height in mm)."""
    k = DEFAULTS[model]["scale"]
    y0 = 200.0 if model == "dog" else 300.0
    if name == "bumps":
        return terrains.bumps(max_height=height or 12 * k, y0=y0)
    if name == "rocks":
        return terrains.rocks(max_height=height or 15 * k, y0=y0)
    if name == "rubble":
        return terrains.rubble(max_height=height or 20 * k, y0=y0)
    if name == "bars":
        h = height or 20 * k
        return terrains.bars(heights=(h / 2, h), spacing=300, y0=y0)
    if name == "step":
        return terrains.step(height=height or 20 * k, y0=y0, length=500)
    if name == "drop":
        return terrains.drop(height=height or 15 * k, y0=150.0 if model == "dog" else 200.0)
    if name == "gaps":
        # deeper than maxStep (dog 30, hexapod 45 mm): a hole, not a step down
        if model == "dog":
            return terrains.gaps(height=height or 50, widths=(25, 50, 150), y0=350)
        return terrains.gaps(height=height or 70, widths=(40, 80, 220), y0=400)
    if name == "bridge":
        if model == "dog":
            return terrains.bridge(height=height or 40, ramp=450, gap_widths=(25, 35), width=300, y0=200)
        return terrains.bridge(height=height or 70, ramp=450, deck=1000, gap_widths=(40, 55), width=520, y0=250)
    if name == "course":
        return terrains.course(scale=k, y0=y0)
    return terrains.SCENES[name]()


_cores = {}


def core(model):
    """One FirmwareCore per model and process (the C++ side is global state)."""
    if model not in _cores:
        _cores[model] = FirmwareCore(model=model)
    return _cores[model]
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
