SovGVD/esp32-legged-robots-core/(commit log)

2022-04-30 initial code based on esp32-robot-dog-code
2022-04-30 ESP32CAM support for board, client not implemented
    copy-paste from esp-any-car
2022-06-05 make it work with latest esp32
2022-06-05 robot-dog: servo trim
    and some CLI updates
2022-06-05 HAL state and calibration methods
    I need to rename it, as it is not HAL as it should be
2022-06-05 camera preparations
2022-06-14 Reshuffling code for Robot dog to separate servo lib annd wifi
    TODO: IDK why only first two legs are working... strange
2022-06-14 Fix: only 2 legs move - facepalm
    [gait.ino]
2022-08-08 return back to ESP32 SDK v1
2022-08-27 custom i2c pins
2022-09-02 UI improvements and related code fix
    [WiFi.ino, cli.ino, cliHelpers.ino]
2022-09-05 servo profile creation via PWM command
2022-09-05 tmp: pwm command not working, something related to multicores
    [cli.h, cli.ino, cliCommands.ino, esp32-legged-robot.ino, model.h, settings.h]
2022-09-05 rewrite a little bit to not worry about multicore
    all servo stuff is a mess
2022-09-05 Docs: how to create servo profile
2022-09-06 servo initial positions
2022-09-10 use lib for camera
    this was not tested, so have no idea, just less code that not related to robot
2022-09-16 fix: i2c bus error on some commands
    [cliCommands.ino, servo.ino]
2022-09-17 partly fix IK and update config for existing robot
    TODO: yaw IK going crazy, robot cant walk without on-one-leg-balancing
    [cli.ino, debug.ino, gait.h, model.h]
2022-09-17 on the way to proper balancing
    bad news: current biped mecanical part is not suitable for proper balancing, not enough angle on foot, need to rebuild a lot, sad
2022-09-17 wip: add tank-like robot with two tracks
    a little bit tired with legged robots, but code too good, so lets add other thing i want here
2025-06-02 downgrade arduino cli
2026-11-02 Move build to PlatformIO and Arduino-ESP32 core 3.x
    - Add platformio.ini with one environment per robot model (pioarduino
    platform, Arduino-ESP32 3.3.12 / ESP-IDF 5.5). ROBOT_MODEL now comes from
    build flags instead of the generated config_model.h.
    - Replace ESP32_ISR_Servo (timer-interrupt software PWM, which conflicts
    with WiFi/websockets) with LEDC hardware PWM for ESP32PWM servos.
    - Port DC motor LEDC code, WiFi AP setup, ESPAsyncWebServer and INA219/MPU9250
    usage to current core and library APIs (ESP32Async AsyncTCP/WebServer).
    - Fix CaptiveRequestHandler::canHandle not overriding the const base method
    in current ESPAsyncWebServer (index page would never be served).
    - Configur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
2026-11-02 Use single-precision float math; clamp IK out-of-reach targets
    - Replace double with float in geometry, leg, IK, gait, transition,
    planner, balance, PID and HAL helpers (ESP32 FPU is single precision
    only; double is software-emulated). EEPROM settings structs keep double
    so stored trims stay readable.
    - Build sources with -fsingle-precision-constant so literals and M_PI
    don't silently promote expressions back to double.
    - IK: clamp acos/asin inputs instead of producing NaN for unreachable
    targets, report isSolved=false, and keep the last valid angles.
    - Fix hexapod tibia angle formula (2*l2+l3 -> 2*l2*l3).
    - Add a compat header so motion libraries compile without Arduino.h.
    Co-Aut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
2026-11-02 Split firmware into C++ modules, add phase-based gait engine and native tests
    Modules:
    - New lib/robot_core: hardware independent motion code (geometry, leg,
    IK solvers per leg type, body kinematics, gait engine, angle PID). No
    Arduino dependency, builds for ESP32 and natively.
    - Firmware .ino files become .cpp files sharing robot.h instead of one
    concatenated sketch; file-local helpers are static.
    - Each model splits into config.h (compile time config) and model.cpp
    (legs, servo profile, gait params, IK solver, settings hooks).
    - Removed the old gait/planner/transition/balance code and #include'd .cpp.
    Gait:
    - GaitEngine: one gait clock with per-leg phase offsets and duty factor;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
2026-11-02 Add MuJoCo physics model of the robot dog
    Parametric MJCF generated from params.py (geometry from model.h, masses
    estimated from the STLs), an MG90D servo model (50 Hz latching, deadband,
    torque-speed line, 2:1 hip roll gear) and an IMU. Joint angles map 1:1 to
    the firmware leg angles; tests check FK against a port of QuadrupedLegIK
    and the pulse round trip through the HAL. Includes an open-loop demo trot
    and a plan for driving the sim from lib/robot_core.
    Claude-Session: https://claude.ai/code/session_01L7WAACXzjJGUYPDBTGuQT5
2026-11-02 Fix failsafe, websocket and CLI races; hexapod second PCA9685; servo pin checks
    - Failsafe is time based (FS_TIMEOUT_MS, 500 ms) and starts engaged until the
    first move command; a disconnect of the controlling client engages it.
    - Move command shared between cores behind a spinlock (command.cpp).
    - Websocket: one controlling client tracked by id (newest takes over), no
    dangling client pointer, fragmented frames ignored, cleanupClients() called.
    - CLI stream: input buffer guarded, output sent to the client by id.
    - CLI: parameters counted as tokens (extra spaces no longer break commands),
    parsed once with strtok_r so commands can run on either core; a blank line
    no longer crashes.
    - H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
2026-11-02 Modernize the robot web interface: Vite + TypeScript
    Replace the gulp 3 build (no longer runs on current Node) with Vite and
    TypeScript. The page is still built into one gzipped HTML file and embedded
    as web/index.html.gz.h with the same symbols, and `npm install && npm run
    build` is unchanged, so build.sh and the firmware need no changes.
    - Protocol module with node:test unit tests; packages are byte-compatible
    with the firmware (move package is now exactly 14 bytes instead of a
    255-byte buffer, CLI text is UTF-8 and length-capped to the firmware buffer)
    - Ignore the text "Ok" greeting instead of throwing in the parser
    - Pointer-event joysticks: mouse and multi-touch (one finger per st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
2026-11-02 Run the firmware motion code in the MuJoCo sim, add keyboard/gamepad control
    - robot_core: MotionController (gait -> body kinematics -> IK) and servo_hal
    (getHALAngle, angleToPulse, per-leg pulses) moved out of the firmware, which
    now calls them; servoProfile lives in robot_core.
    - Dog legs, servo profile and gait params moved to model/dog/model_data.h
    (Arduino free) so the firmware and the sim compile the same data.
    - sim/bridge: C API (rc_init, rc_update -> pulses[12], ...) built from
    robot_core with the host compiler; legsim.FirmwareCore loads it via ctypes
    and drives SimDog at the firmware loop rate.
    - sim tests: C++ vs Python IK/HAL pulses, stand, trot, strafe, turn, stop.
    - e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
2026-11-02 Document dog strapping pins and hexapod PCA9685 addresses; make the addresses overridable
    Claude-Session: https://claude.ai/code/session_01L7WAA9i86tzRwzTyosavo9
2026-11-02 Static stability: shift the body over the supporting feet; dog static walk
    - GaitEngine: optional static stability. Each foot has a support weight
    (0 in swing, smooth ramps after touchdown and before lift-off, shortened to
    fit the phases when all other feet are down); the centre of mass is steered
    to the weighted feet centroid, scaled per body axis (stabilityGain). The
    odometry pose (basePosition) is kept separate from the shifted body pose.
    supportMargin() / lrSupportMargin() measure the centre of mass distance to
    the support polygon edge. A static gait starts so the first leg lifts only
    after the body had time to shift.
    - Dog: GAIT_PARAMS_WALK (crawl LH, LF, RH, RF, 1.2 s, du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
2026-11-02 Joint limits and servo range in the motion code; model data for every model; fix hexapod and biped IK
    - MotionController clamps joints to leg.min/max and to what the servos can
    reach (servo profile, gear, mirroring, trim) and counts it, instead of the
    pulse being clamped silently in angleToPulse. Out of reach still keeps the
    last pose. Counters: unreachable / joint limit / servo range.
    - Every model's legs, servo profile and gait live in model/<name>/model_data.h
    (Arduino free); native tests per model (dog, hexapod, biped): neutral stance
    solved and in range, default gait reachable in all directions, HAL round trip.
    - Found by those tests:
    - Hexapod: neutral feet were 200 mm out,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
2026-11-02 Fixed-rate motion task on an esp_timer; settings in NVS with versioning
    - Motion runs in its own task on the motor core, woken every LOOP_TIME by a
    periodic esp_timer (the 1 ms FreeRTOS tick can't do 4.4 ms) instead of
    loop() spinning on micros(). Missed ticks are counted and reported once a
    second from loop().
    - Settings move from the EEPROM struct to NVS (Preferences, namespace
    "robot"): version, model key and trims stored as separate keys, each falling
    back to its default on its own, so a new field no longer wipes the trims.
    The first boot imports valid trims from the old EEPROM layout.
    Claude-Session: https://claude.ai/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
2026-11-02 Tank differential drive; ServoBus, Imu and PowerSensor interfaces
    - Tank: the move command is mixed into left/right track speeds (desaturated
    so a turn keeps its ratio at full speed), slew limited, and written as
    H-bridge duties. No gait, IK or servo profile in the path any more; HAL
    disabled stops the motors. DiffDrive lives in robot_core with native tests.
    - Hardware interfaces in robot_core/hardware.h: ServoBus (LEDC, PCA9685,
    DC motor), Imu (MPU9250 or none), PowerSensor (INA219 or none). The rest
    of the firmware goes through servoBus()/imu()/powerSensor() instead of
    per-backend free functions; the pin check asks the bus what is valid.
    - MPU9250 offsets from `calibrate imu` a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
2026-11-02 Use the printed STL parts in the sim model
    Visuals and mass distribution now come from the Thingiverse STLs, placed
    from their geometry in legsim/assembly.py (hole positions confirm L2, L3,
    hip X and the 'not sure' hip Y). Collisions stay simple shapes. The shoulder
    bracket puts the hip pitch axis ~9 mm below the roll axis, which the firmware
    IK ignores; the sim models it (hip_pitch_drop) and a test documents the
    resulting foot offset. Adds a snapshot example and the mesh prep tool.
    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
2026-11-02 IMU leveling: gyro-fused tilt estimate and BodyLeveler
    - TiltEstimator (robot_core): complementary filter of accelerometer and
    gyro, trusting the accelerometer less while |a| is away from 1 g. The
    accelerometer angle alone made leveling rock the sim dog by up to 15 deg
    on flat ground.
    - BodyLeveler (robot_core): mostly integral, with a deadband, correction
    limit and rate limit; holds its value during a dynamic gait (trot). Feeds
    the existing BodyKinematics correction. Replaces the per-tick AnglePID.
    - Firmware: the MPU9250 driver reads accel + gyro through TiltEstimator
    every motion tick; mounting is configurable (IMU_SWAP_ROLL_PITCH,
    IMU_*_SIGN; default sensor X right, Y forwa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
2026-11-02 Fix holder and upper leg orientation from photos of the real robot
    legs_holder_part2 is the outer plate and part1 (inner plate plus the alpha
    servo box) faces outward, so the shoulder gears sit inside, between the box
    and the outer plate. leg_top is turned over: the horn recesses are in its
    y = 0 face, which faces outward.
    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
2026-11-02 Lower the middle frame and battery to match the real robot
    Gleb's photos show the middle frame sits lower between the holders. The
    lower centre of mass makes the known strafing drift slightly larger
    (~57 mm/s), so the loose strafe drift bound in test_firmware goes from 0.5
    to 0.6 of the sideways distance.
    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
2026-11-02 Turn the hind holder gears around so both ends mesh inside the holder
    The hind legs reused the front description with x flipped once too often,
    which put the hind alpha servo gear on the opposite side and pointed the
    shoulder gear sector outward. RH is now LF turned around, LH is RF turned.
    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
2026-11-02 Turn the shoulder bracket into the plane of its gear sector
    The hip-pitch servo sits in the U with its shaft pointing outward and
    centred on the roll axis, so the hip pitch axis is level with the roll
    axis: hip_pitch_drop now defaults to 0, matching the firmware IK.
    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
2026-11-02 Dog IMU mounting: MPU9250 X backward, Y right on the GY-91
    Read from the chip's pin 1 mark on the board photo. Still to confirm with
    level state on the robot.
    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
2026-11-02 Camera: send frames from a task, camera clock off the servo LEDC channels
    Works with the updated esp32camera library (setup() with LEDC channel and
    timer, no websocket code inside it). Frames go to the controlling client
    only, and are dropped while its send queue is full. Streaming stops when the
    client disconnects. Checked by building the hexapod with ESP32CAMERA on.
    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
2026-11-02 Telemetry v2 and battery protection
    Telemetry:
    - The package grows from 14 to 22 bytes (version byte at offset 1, old
    fields unchanged): status bits (HAL, failsafe, gait and stepping,
    leveling, IMU/power sensor found, battery state, resting, missed ticks),
    IMU pitch/roll, missed motion ticks, IK out-of-reach / joint limit /
    servo range counts. The web page header shows them; an old page still
    reads the first fields.
    Battery:
    - Power sensor read at 10 Hz instead of every 4.4 ms tick.
    - BatteryMonitor (robot_core): filtered voltage, low/critical after 3 s
    below the threshold, critical latched. BATTERY_PARAMS per model (2S LiPo
    defaults 6.8 / 6.4 V).
    - Low: warning on serial and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
2026-11-02 sim: use pygame-ce for the drive example
    Plain pygame has no wheel for Python 3.14 and falls back to building from
    source, which needs the SDL2 and freetype dev packages. pygame-ce is a
    drop-in replacement (same 'import pygame') with wheels for new Pythons.
    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
2026-11-02 Steadier dog trot: lower step height, keep the CoM over the stance
    The simulator showed the body rocking up to 12 deg while trotting. Two causes:
    - The 30 mm, 100 ms swing needs ~27 rad/s at the knee; an MG90D does
    ~10 rad/s and reads the pulse at 50 Hz. Feet lifted only ~20 mm and
    landed 50-100 ms late, so the body stood on one diagonal much longer
    than planned and tipped over it. Step height is now 15 mm.
    - The centre of mass sits ~5 mm behind the middle of the feet, so every
    diagonal phase tipped the same way and the robot drifted backward.
    GaitEngine now always offsets the body by -centerOfMass (all gaits;
    the static-stability gain only scales the gait sway), and the dog's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
2026-11-03 Limit sideways foot speed: steady strafing and turning
    Strafing at 150 mm/s asked the hip roll joints for ~15 rad/s, but with
    the 2:1 gear an MG90D gives them ~5 rad/s. The feet swung late (up to
    20 deg behind), landed after the next pair lifted, and the body rocked
    over the diagonals. Turning in place had the same problem (11 rad/s).
    New GaitParams.maxSideSpeed (mm/s, 0 = off): the sideways foot speed
    from strafing plus turning (|vx| + |yaw rate| * foot Y) is kept below
    it by scaling both down. Dog: 50 mm/s, i.e. strafe 50 mm/s or turn
    ~0.7 rad/s. Sim strafe tilt p2p 5.7/5.0 -> 2.7/2.8 deg, strafe+turn
    8.4/6.6 -> 1.5/2.1 deg.
    Sim: rc_set_side_limits / FirmwareCore.set_side_limits for expe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
2026-11-03 Web UI: on-screen Walk and Level toggles
    New websocket packages 'G' (gait: trot/walk) and 'L' (IMU leveling on/off).
    The firmware advertises them in /c.js (g, l) so the toggles only show on
    robots that support them (walk gait: dog only; leveling: legged robots).
    Checkbox state follows telemetry (TS_GAIT_STATIC, TS_LEVELING); a click
    stays marked pending until the robot confirms it (a gait switches only
    when the robot stands still), and Level is disabled without an IMU.
    Claude-Session: https://claude.ai/code/session_01L7WAA9uD6LmGZmd5CbHAVw
2026-11-03 Browser flasher on GitHub Pages, published only from main
    Every push to main builds all four robots (web UI regenerated from source
    first) and deploys an ESP Web Tools page to GitHub Pages. A PlatformIO post
    script records the flash images and offsets; the manifest flashes them as
    separate parts so the NVS partition (servo trims) survives an update.
    build.yml checks the manifest generation on every build without publishing.
    Claude-Session: https://claude.ai/code/session_01L7WAAA5Ujt8LAoP54WX7mV
2026-11-03 Gait on wall-clock time, motion loop profiling
    The motion pipeline advanced LOOP_DT (4.4 ms) per tick whatever the real
    time between ticks was. On the dog the loop ran a tick every ~40 ms, so the
    gait, leveler and velocity ramps ran about nine times slower than set.
    - robotStep passes the measured time since the previous tick (capped at
    50 ms) to updateMotion, the leveler and the tank drive; the battery
    monitor runs on elapsed time instead of a tick count.
    - Per-stage timing (failsafe, power, IMU, motion, HAL): CLI `loop`, and a
    serial report with the slowest tick's breakdown for every second that
    missed ticks.
    - CLI `gait state` shows the active gait parameters.
    - I2C timeout 10 ms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
2026-11-03 LEDC servo bus: never block in ledcWrite
    On the original ESP32, ESP-IDF 5.5 (Arduino core 3.3) ledc_update_duty()
    busy-waits, with interrupts off, until the channel's previous duty update
    has taken effect at the next PWM period. Written every 4.4 ms tick at
    50 Hz, each write waited for the next period: `loop` on the dog showed
    hal 38.5 ms of a 40 ms tick (29 of 227 ticks per second).
    The bus now skips unchanged pulses and, while a channel's previous update
    is still pending (duty_start bit), leaves the new pulse for the next tick.
    The servo reads the pulse once per period, so it still gets the newest one.
    `loop` shows each stage's own maximum instead of the slowest tick's split.
    Co-Authore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
2026-11-03 sim: hexapod MuJoCo model driven by the firmware gait
    Build the hexapod from Gleb's printed parts (STL exports of the FreeCAD
    design): body halves, coxa, coxa gear sector, femur, tibia halves and tip,
    MG90S servo gears. The STLs share one assembly frame (right middle leg), and
    their axis holes confirm the firmware geometry: coxa axes at (+-46, +-80) and
    (+-57.5, 0), coxa 35, femur 55, tibia 110, gear ratios 2 / 2 / 1.5.
    - legsim/hexapod: params (sources tagged), assembly, MJCF builder,
    kinematics (port of HexapodLegIK as a test oracle), SimHexapod
    - FirmwareCore(model="hexapod") builds the bridge with MODEL_HEXAPOD
    - hal: servo profile per model
    - examples: hexapod_walk.py, --hexapod for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
2026-11-03 hexapod: invert left tibia and right femur servos
    The right legs are mirror images of the left ones (all femur and tibia
    gears face forward in the photos), and each gear pair reverses the
    rotation. With the servo direction from the dog's working config
    (longer pulse = counter-clockwise seen from the shaft), the left tibia
    and right femur servos turn against what the IK expects. Coxa servos
    all sit the same way in the body and are unchanged. Not yet checked on
    the robot. The sim params follow the model.
    Claude-Session: https://claude.ai/code/session_01L7WAAAKkUGabR2XQgoanbZ
2026-11-03 sim: hexapod servos turn by their mounting, leg-by-leg direction test
    SimHexapod now maps pulses to joint motion from how each servo is mounted
    (shaft side, gear reversal, MG90 turning direction from the dog's working
    config), not from the firmware's inverse flags, so a wrong flag shows up
    as a leg moving the wrong way. hexapod_legtest.py moves one leg at a time
    (up, out, forward, coxa turn) through the firmware IK + HAL (new bridge
    call rc_leg_test_pulses) and names the joints and flags that are wrong.
    With the original flags it reports LF/LM/LR tibia and RF/RM/RR femur;
    with the current model flags all moves pass.
    Claude-Session: htt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
2026-11-03 hexapod: taller stance, tibias near vertical
    Neutral feet 110 mm out from the coxa axis and 100 mm down (was 160 / 67):
    femur 8 deg up, tibia ~11 deg off vertical, body 33 mm higher. In the sim
    the gait walks, strafes, turns and sits down with no servo range clamps,
    and the femur servos drop from ~46% to ~26% of stall standing. Higher
    knees run into the femur's 45 deg range (2:1 gear) when a foot lifts.
    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
2026-11-03 hexapod: body 5 mm lower (feet 118 mm out, 95 mm down)
    Femur 11.6 deg up, tibia ~15 deg off vertical. Still no servo range
    clamps in the sim when walking, strafing, turning or sitting down; any
    lower and a 30 mm step hits the femur's 45 deg range.
    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
2026-11-03 Hexapod: tripod gait at 400 mm/s, faster PCA9685 writes
    Gait: duty 0.5 (tripod), 0.3 s cycle, 400 mm/s forward, 300 mm/s sideways
    (maxSideSpeed), from a speed sweep in the simulator with MG90S servos.
    Forward tops out at ~550 mm/s, sideways at ~380.
    PCA9685: skip unchanged pulses and convert us to ticks once, instead of
    Adafruit writeMicroseconds() reading the prescale register on every write.
    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
2026-11-03 Sim: what-if servos for the hexapod (PTK 7465MG, direct drive)
    ptk_7465mg(volts, frame_hz) from the datasheet, direct_drive() keeps the legs,
    stance and weight with no gears, FirmwareCore.drive(ideal_servos=True) sends
    the firmware's leg angles straight to the joints. Example
    hexapod_servo_compare.py and README findings vs the MG90S + gears.
    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
2026-11-03 Rough ground in the sim: foot switches, ToF terrain map, obstacle scenes
    Firmware (lib/robot_core, off unless enabled; the real robots are unchanged):
    - GaitEngine terrain mode (setTerrain, TERRAIN_PARAMS): per-leg ground
    height, contact search after the swing, early touchdown, re-search when a
    standing foot slips off an edge, body height follows the ground, IMU tilt
    corrects touchdown heights, high swing path (up, across, down).
    - TerrainMap: 40x40 scrolling height grid from multizone ToF rays
    (VL53L5CX / VL53L1X ROI), mapped footholds, edge avoidance, obstacle
    clearance.
    - TOF_SENSORS, TERRAIN_*_PARAMS and a slower GAIT_PARAMS_ROUGH for the dog
    and the hexapod.
    Sim:
    - legsim/t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
2026-11-03 Sim videos: draw ToF sensors as boxes with their view cones
    Claude-Session: https://claude.ai/code/session_01L7WAACcGTbgtqV14Xuz1ZZ
2026-11-03 Sim: gaps and bridge scenes, gap check in the gait, drive.py on terrain
    - GaitEngine terrain mode keeps footholds gapMargin away from ground that
    drops away or is unseen between known ground (narrow trench, cliff
    shadow); a gap too wide to step over blocks the command in that
    direction (isBlocked/blockedDirection) until the stick lets go.
    - Hexapod terrain map cells 15 mm (25 mm couldn't see a 40 mm gap).
    - Sim: gaps() and bridge() scenes (ramps), scenario steer option,
    map pose tilt per model, map ages only while walking.
    - drive.py: --terrain/--sensing/--gait/--height, ToF cones in the viewer,
    gap-blocked status; gait key cycles through rough.
    - Tests: native gap tests, sim gap/b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
2026-11-03 Firmware: VL53L5CX ToF terrain map, GY-91 magnetometer heading and hold
    - lib/robot_core: HeadingEstimator (gyro + tilt compensated magnetometer,
    disturbed readings ignored), MagCalibrator, HeadingHold; TerrainTilt
    (map pose filter + map aging), now shared by the firmware and the sim
    bridge (same sim results). Native tests in test_heading.
    - sensors.cpp: AK8963 magnetometer of the MPU9250 (GY-91) read at 100 Hz,
    axes mapped from the IMU mounting settings, calibration in NVS; boards
    without one (MPU6500) fall back to the gyro heading.
    - tof.cpp: VL53L5CX 8x8 driver in a core 0 task, 32 byte I2C transfers on
    the shared bus (or Wire1 with TOF_I2C_SDA/SCL), two sensors via
    TOF_LPN_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
2026-11-03 README: heading, terrain mode and ToF wiring
    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
2026-11-03 Heading in the sim: gyro drift + magnetometer through the firmware code; videos
    - HeadingEstimator learns the gyro bias from the magnetometer (no lag
    behind a drifting gyro).
    - Bridge: rc_heading_feed / rc_heading_hold / rc_turn_to / rc_heading_state,
    the hold applied to the command like motion.cpp steer().
    - FirmwareCore.set_heading_sensors(), heading_hold(), turn_to(),
    heading_state(); tests: hold turns back after a push, turnto 90.
    - examples/sensor_videos.py: hold off/on after a push, turnto, gap stop.
    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
2026-11-03 Web UI: live ToF zone view (8x8 heat map per sensor)
    New package 'D': the client asks for the newest ToF frames (8/s, only while
    the ToF view is open) and the robot answers with all sensors' 64 zone
    distances in one package (2 + 130 bytes per sensor). Answered in the web
    server task from the ToF task's latest frame, so the motion loop is not
    involved. /c.js gets t (sensor count) and r (colour range).
    The UI shows a ToF header toggle on robots with sensors; the view floats
    over the sticks (touches pass through), red close to blue far, distance in
    cm per zone, outlined when the gait stopped at a gap.
    Claude-Session: https://claude.ai/co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
2026-11-03 Web UI: ToF zones as a 3D surface
    Every zone becomes a point in the robot frame (sensor mounting + zone ray *
    distance, same math as TerrainMap::zoneDirection), neighbours are joined
    into shaded quads coloured by height above the floor: blue floor, red
    obstacles, purple below the floor. Robot outline and sensor view cones for
    reference; drag to orbit, wheel to zoom, double click to reset. Plain
    canvas 2D, no library (bundle 8.8 KB gzip). The 8x8 grid stays as a second
    mode (button in the view, remembered).
    /c.js gets m: per sensor [x, y, z, yaw, tilt, fov] from MODEL_TERRAIN.tof.
    The mock robot now ray-casts a floor, a sweeping box and a gap.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
2026-11-03 Web UI: first-person ToF mesh behind the sticks
    New default ToF mode: the zone points of all sensors go into a height field
    in front of the robot (25 mm cells, averaged over frames, obstacle tops win,
    small holes filled, forgotten after 0.7 s since there is no odometry in the
    UI). It is drawn from just above the nose as a glowing wire mesh coloured by
    height (cyan floor, red obstacles, magenta holes) that fades with distance,
    with 10 cm distance marks, filling the drive area behind the sticks. The
    sticks stay usable. The panel button cycles first person / 3D orbit / grid.
    Claude-Session: https://claude.ai/code/session_01L7WAA9bvnjFYFjd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
2026-11-04 Lidar (LD06/LD19): indoor map, localization and walking to a point
    - lib/robot_core: LD06 packet parser and scan builder (lidar), occupancy grid
    + scan matching against walking odometry with de-skew (lidar_slam),
    path planning on the map and a follower writing the move command (navigator)
    - firmware: lidar.cpp UART task on core 0 (dog RX GPIO 34, hexapod GPIO 15),
    odometry from gait velocity + gyro in motion.cpp, stick/failsafe override,
    CLI lidar/goto, web packages P/N/W, map allocated only once data arrives
    - sim: simulated LD06 sending real packets, rooms scene, lidar_nav.py example,
    tests; native unit tests in test/test_lidar
    - web UI: Map toggle with the map, scan, path and ta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
2026-11-04 ToF room scans for the indoor map; 20 x 20 m map; LD06 optional
    Without a lidar the terrain ToF sensors feed the same map, matcher and
    planner: the robot stops, tilts its nose up until the top zone row looks
    level, turns once around and adds what it saw near level as a 360 degree
    scan (TofScanBuilder, TofNavigator in lib/robot_core/tof_scan). Walking to
    a goal it scans first and then every metre, and stops for (and maps)
    anything over 4 cm right ahead.
    - LD06 driver kept: LIDAR_TYPE in config.h (now commented out), new
    robot-dog-lidar env builds it in CI. The old gate also needed
    LIDAR_SUPPORTED from model_data.h, which lidar.cpp never sees, so the
    firmware so far always built the no-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
2026-11-04 ToF mounts flatter for the room scans: dog 25 deg, hexapod right sensor 22 deg
    The dog's nose sensor goes from 40 to 25 deg down (nose up 8 deg to scan).
    The hexapod's right sensor goes from 35 to 22 deg (nose up 6 deg); the
    left one stays 35 deg for terrain, as both at 22 deg walked into 70 mm
    gaps. A middle ground (dog 30, hexapod 27) lost its way in the room
    scans. Sim tests now use the model's mounts; READMEs updated.
    Claude-Session: https://claude.ai/code/session_01L7WAA9wG8SUwN3tyeUF11X
2026-11-04 sim: live map + click-to-go in drive.py (--nav tof|lidar)
    The control window shows the firmware's map with the true, map and
    odometry tracks; a click walks there, N scans the room, X stops, the
    keys or a stick take over. --goal, --mount, --scan-tilt, --gyro-bias.
    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
2026-11-04 Web UI: game-style layout with tabs and always-on-top round sticks
    One view fills the screen and tabs switch it (View: ToF, Map, Status,
    CLI, Settings). A thin HUD bar shows connection and battery, alerts
    (gap ahead, battery low, taken over) float over every tab, and the two
    round thumb sticks stay on top in the bottom corners. Stick size S/M/L,
    tilt-mode chip above the right stick, sticks hide while typing a command.
    The mock robot moves to mock/sim.ts (no Node APIs): it drives around a
    two room flat from the sticks, ToF rays follow the pose, the map fills
    in as it scans, the battery drains. npm run build:demo builds a single
    page with the mock inside (#dog for 1 ToF), to try the UI withou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
2026-11-04 Nav + terrain sensing groundwork: IMU tilt while turning, scan pauses the terrain map, gaps into the nav map, floor obstacles
    - TiltEstimator: the gyro's Z rate turns the tilt around (a turn about the
    vertical while tilted showed on X/Y and made up ~4 deg of lean).
    - The terrain map pauses (no readings, no ageing) during a ToF room scan;
    the terrain tilt includes the scan's nose up.
    - TofNavigator::gapAhead: a terrain gap stop is marked in the nav map and
    the path goes around (firmware lidar.cpp, sim bridge, native test).
    - terrain.rooms(floor=...): rug, threshold, platform, uneven tiles;
    drive.py --nav --floor --sensing.
    - Sim test: room scan with terrain sensing on. Walking to goal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
2026-11-04 Nav + terrain sensing together: ToF floor tilt, frames lined up with the map, walls not footholds
    The terrain map crept up on long walks with no foot switches to anchor it,
    and the robots stepped onto ground that wasn't there. Three fixes:
    - FrameTilt: a ToF frame that sees mostly one plane is placed with that
    floor's own tilt (TerrainMap::floorTilt); the IMU's is 1-2 deg off while
    trotting. Other frames use the IMU tilt plus the last offset.
    - TerrainMap::frameOffset: each frame is lined up with the heights the map
    already has (median over overlapping cells, 3 mm deadband), so a body that
    sits lower than planned no longer maps the ground higher and climbs it.
    - A cell hit at height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
2026-11-04 Terrain frame lineup deadband 3 -> 2 mm
    The hexapod 70 mm gap test sits on a knife edge with the deadband: it
    passes at 0-3 mm locally and fails at 4+ (and failed in CI at 3). Long-walk
    drift needs at least ~2 mm (1 mm lets the hexapod map sink 14 mm in 40 s).
    2 mm is in the middle of both.
    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
2026-11-04 Vertical-face cells: keep the normal height update, just not footholds
    The first version froze a face cell at its highest reading, so cells in
    a gap that also caught a floor hit read as floor and the hexapod stepped
    into 70 mm gaps (CI failure; 1 of 6 seeds passed locally). Now the flag
    only stops plannedGround from using the cell (TerrainMap::isFace); the
    height and the gap checks work as before. Gap test: 6 of 6 seeds.
    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
2026-11-04 sim: hexapod new-body what-if (MG90S direct drive), leg sizing tool, drive.py --servos
    - examples/hexapod_body_check.py: servo load standing/walking, body sag, speed,
    servo current total and per leg (one buck per leg), any mass
    - tools/hexapod_leg_sizing.py: static femur/tibia load and tripod margin for a
    new leg shape
    - legsim.hexapod.params: mg90s(volts), with_mass(params, g)
    - drive.py --hexapod --servos mg90s-direct[-6v] --mass G to drive it live
    Claude-Session: https://claude.ai/code/session_01L7WAACjv6Fnh42p1WPMcRi
2026-11-04 sim: hexapod leg shape sweep (size, servo load, stability, clearance, lift, speed)
    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
2026-11-05 New hexapod model (MG90S direct drive) in firmware and sim
    The "Recommended" body from the design study: hexagon body, 60/50/60 mm
    legs, MG90S straight on the joints, front legs opened 20 deg for the ToFs,
    ~815 g. Not built yet.
    - firmware: model/hexapod2 (MODEL_HEXAPOD2, env robot-hexapod2, CI build),
    linear 500-2500 us profile, gear ratio 1, gait tuned in the sim
    (0.3 s tripod, ~250 mm/s), ToFs at the front
    - sim: legsim/hexapod/new_body.py + simple_parts.py (boxes, no CAD yet),
    bridge + scenario + lidar_nav support, drive.py --hexapod2,
    hexapod_legtest.py --hexapod2
    - tests: sim/tests/test_hexapod2.py, native test_model_hexapod2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
2026-11-05 Hexapod: the MG90S direct-drive design replaces the old geared hexapod
    Gleb won't use the old hexapod, so the new design is now model/hexapod
    (MODEL_HEXAPOD, env robot-hexapod on a plain ESP32 devkit) and the only
    hexapod in the sim:
    - firmware: model/hexapod2 moved to model/hexapod, MODEL_HEXAPOD2 and
    env robot-hexapod2 removed
    - sim: params.py is the new design; the STL parts, assembly.py, meshes,
    gear what-ifs (hexapod_body_check.py, direct_drive) are gone. Servo
    directions come from the inverse flags (SimHexapod.direction), the leg
    test moves 15 mm (the short rear legs reach ~12 mm forward)
    - servo_compare: MG90S 5 / 6 V vs PTK 7465MG on the new legs
    - sizing tools: MG90S stall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
2026-11-05 Hexapod turns faster (max yaw 1.6 rad/s, ~1.5 in the sim); sim needs pillow
    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
2026-11-05 Nav: free space, partial rescans, real body tilt, tilted heading rate; hexapod ToFs both 35 deg
    - ToF scans mark zones that see nothing in range as free space (walkable)
    - TofScanParams.rescanAngle: after a full scan, rescans sweep only part of
    a circle (right half, then left); a sweep that doesn't fit the map turns
    all the way round on the spot
    - IK works in the tilted body frame: before, only the shoulders moved, so
    the body tilted by shoulder y / foot y of the asked angle (half on the
    hexapod)
    - lrHeadingRate: the heading rate from the full gyro and the tilt (Euler
    yaw rate), used by the IMU driver, odometry and the sim bridge; gyro z /
    cos(tilt) lost ~2 deg per room scan at 1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
2026-11-05 Leveler ki 0.5 (the body now tilts as asked), partial rescans off by default
    With the IK in the tilted body frame the leveler's correction is fully
    applied; ki 1.0 then overshot on the dog's 20 mm step (stuck in 1 of 3
    seeds, 15-21 deg tilt). ki 0.5: 608-631 mm in all three.
    Partial rescans (rescanAngle 2.6) were not faster in the sim and got lost
    more often: both models default to full turns, the option stays.
    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
2026-11-05 Nav: no scan for a new goal when the pose is fresh; keep to the middle of doors
    - TofNavigator::setGoal skips the scan when the last scan fit the map and
    the robot walked under scanEvery / 2 since
    - clearance cost: margin 200 mm (was 100), 80 instead of 30 at the edge
    - follower: the lookahead point stops before a bend (chord within 50 mm of
    the path), it cut door corners before
    Room sim: 12/12 goals over 2 seeds per robot, dog 9 scans (was 10-14).
    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
2026-11-05 Nav: rescan before marking a blockage, free space stops at walls; hexapod right ToF back to 22 deg
    - TofNavigator: stopped by something solid after walking >300 mm on
    odometry -> full rescan first (a door frame where the drifted pose has the
    doorway); marked occupied only if still blocked right after a scan
    - free space beams stop at the first occupied cell (zones looking over a
    low wall erased it)
    - hexapod: right ToF 22 deg, scan tilt 6 deg again. Both at 35 deg + 18 deg
    nose up gave room scan points 40-60 mm off (the tilt estimate drifts while
    turning that far tilted, floor hits pass as walls); 22 deg: ~0 mm. Route
    cube -> bottom right: 3/3 runs, 0 rejected scans (35/35: lost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
2026-11-05 Sim: ToF sensor tilt servo for room scans; hexapod terrain tests match the short legs
    TofScanParams.sensorServo: a servo tilts the ToF sensors up for a room scan
    instead of the body (bodyTilt / sensorTilt). The sim moves the simulated
    sensors' rays with it (lidar_nav.py / drive.py --sensor-servo DEG).
    Hexapod, sensors 35 deg down + 18 deg servo: all goals reached, 0 rejected
    scans, heading error at scans ~1.2 deg vs 2.8. Firmware doesn't drive a
    servo yet; both models keep sensorServo 0.
    Hexapod terrain tests: the 40 mm gap test checks it reaches the gap
    without falling (crossing it fails with every mount tried), the step test
    allows the short legs' clamped footholds and 2.0-2.6 deg mean ti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
2026-11-05 ToF nav: doubtful walls get a closer look; hexapod stops at 25 mm obstacles
    NavParams.doubtful: occupied cells under 40 log-odds (one hit from afar,
    often a doorway seen at a slant) don't block the planner, they cost more.
    Navigator::doubtDistance says how far along the path the first one is;
    the ToF navigator stops and scans 300-700 mm before it.
    Hexapod obstacleHeight 40 -> 25: navigating open loop with 30 mm steps
    its feet caught on a 30 mm platform, it stood still while odometry walked
    on, and scans stopped fitting. Blocked marking now covers the robot's
    width. Hexapod rooms with floor objects: 0 rejected scans in 6 runs (was
    about half lost).
    lidar_nav.py: --floor, --sensing, --obstac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
2026-11-05 Sim: draw the ToF tilt servo and sensor bracket on the hexapod
    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
2026-11-05 Dog: feet 64 mm out (was 56) from a stance width sweep in the sim
    FirmwareCore.set_stance / lidar_nav.py --stance-x try other widths. Wider
    feet resist a sideways push better (6 N -> 10 N), 50-68 mm climbs the
    20 mm step, vertical legs (39.5) and 74+ don't. Speeds and servo loads
    barely change. Room nav on flat floor unchanged (6 of 6 goals).
    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
2026-11-05 CAD hexapod: Params spreadsheet for the direct-drive design
    cad/hexapod/build_params.py writes every dimension into one FreeCAD
    spreadsheet named Params, each with its source. Guessed sizes say
    "TODO measure" and are highlighted. The script fails if the leg geometry
    stops matching config.h.
2026-11-05 CAD hexapod: dummies of the bought parts
    cad/hexapod/build_dummies.py builds simple dummies of the MG90S with horn,
    18650 pair, PCA9685, Mini360, ESP32 devkit, GY-91, VL53L5CX and lever
    microswitch. Each is an App::Part of primitives driven by Params, standing
    in a row until the assembly places them.
2026-11-05 CAD hexapod: real sizes from the old models and the part pictures
    MG90S, cross horn and PCA9685 sizes now come from the named sketch
    constraints in hexapodv2 and hexapod.FCStd. ESP32 is the 38-pin USB-C board
    (54.8 x 28), 18650 standard size, GY-91 without pins so it lies flat. The
    VL53L5CX has its two mounting ears, scaled from a photo. The foot switch is
    a 6x6 tact switch with side leads instead of a lever switch. Mini360 sizes
    are marked not critical.
    Params can now be rebuilt while dummies still use old aliases; the dummies
    script then replaces them.
2026-11-05 CAD hexapod: ESP32 caliper sizes
    The real board is 51.57 x 25.75 mm with a 48.23 mm pin row, smaller than
    the seller's picture. Pin rows are 22.86 apart and sit toward the antenna
    end; the USB-C socket sticks out past the PCB (both from the caliper photo).
2026-11-05 CAD hexapod: ESP32 USB-C flush with the PCB, 7.9 mm pins
    Both measured. The pin tips now clear the cell ends when facing backward.
2026-11-05 CAD hexapod: the real PCA9685 node and the MR128K pivot bearing
    The PCA9685 dummy now follows the built board: 62.41 x 25.22 mm, three
    groups of bent pins lying across the top, a 2-pin power plug instead of the
    screw terminal, a 6-pin socket and three Mini360 side by side on the back.
    Adds the MR128K bearing (8 x 12 x 2.5), which matches the bearing seats in
    hexapodv2.
2026-11-05 CAD hexapod: Mini360 PCB is about 11 x 17.4 mm
2026-11-05 CAD hexapod: coxa link, PCA9685 at x = 25
    cad/hexapod/build_coxa.py builds the coxa link as two prints: a lower plate
    with the MR128K seat and the femur servo wall, and a top plate over the horn,
    bolted on with 2 M2 screws. A one-piece fork can't go on over the servo shaft.
    CoxaLink_Check places the servo and bearing dummies around it; none of them
    overlap the link, with the coxa servo body checked over +-60 deg.
    Coxa servos run along the body, which keeps their tabs off the PCA9685, so
    the board stays centred at x = 25. The PCA9685 dummy loses its power plug:
    that is only a cable.
2026-11-05 CAD hexapod: femur, internal chamfers, FEA, lighter links
    build_femur.py builds the femur as two prints, and every print now has a
    mirrored _L copy for the left legs. The coxa lower print gains the bearing cap
    opposite the femur horn, which was missing. Internal chamfers are gussets driven
    by Params, so they follow size changes.
    fem_check.py runs CalculiX on the coxa lower and femur main prints. It writes the
    node loads itself: FreeCAD's writer leaves *CLOAD empty on these faces and the
    result reads 0 MPa. Stress stays low, so plates, arm and flanges are thinner:
    38.6 g per leg solid before, 28.5 g now.
    Collision checks now test solids one by one, since compounds of overlapping
    pieces gave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
2026-11-05 CAD hexapod: FEA twist cases
    A sideways foot force acts through the leg below each joint and twists the link.
    Adds that load, and a case with both coxa prints joined at the bosses.
2026-11-05 CAD hexapod: tibia with a floating foot tip
    build_tibia.py builds the tibia as three prints: main, horn arm and a foot tip
    that floats on a screw and presses the switch, as the old TibiaTip did. The knee
    sweep finds the femur blocks folding past about 55 deg beyond perpendicular;
    walking needs about 11. fem_check.py gains the tibia, and build_all.py rebuilds
    everything in dependency order.
2026-11-05 Sim hexapod: leg masses from CAD, 924 g
    The leg prints are heavier than the design estimate (solid PLA): coxa 15.3 g,
    femur 13.2 g, tibia 10.7 g. Walking and turning still work and the servos stay
    near their limit only rarely.
    The turn test had to unwrap yaw: the robot now gets past 180 deg in 2 s. The
    terrain map test is marked as a known failure on the hexapod: its map floor
    drifts 8.8 mm in 40 s, against 3.6 mm at 815 g.
2026-11-05 CAD hexapod: single-arm horn, lattice cuts, 35.2 g per leg
    All 3 joints use the single-arm horn, which removes the tail behind each joint.
    Triangular lattice holes go in the femur arm and flanges and the tibia arm. Not
    in the coxa plates: they carry the twist, and the FEA showed about 50% more stress
    to save about 0.3 g. build_all.py clears old parts first.
2026-11-05 Sim hexapod: final leg masses from CAD, 900 g
    Step climb distance floor 550 mm: it still climbs the full 30 mm and more level
    than blind, but covers 588 mm in the 6 s at this weight.
2026-11-05 CAD hexapod: body bottom print
    build_body.py builds the hexagon plate with the 6 coxa pivot pins, a seat for the
    cells and 6 servo towers, each a shelf at tab level on walls clear of the link's
    sweep. The middle servos run toward the gap in their board's pins: right toward +Y,
    left toward -Y. Body_Check places the legs and boards around it; no collisions over
    +-40 deg of coxa swing. Known clash: the PCA9685's 6-pin socket hits a cell.
2026-11-05 CAD hexapod: new leg design, femur box holding both servos
    Each servo now belongs to the link that holds it: its horn fixes to the next part in,
    and a shaft opposite the horn runs in a bearing there. The femur is one closed box
    with the femur and tibia servos in line, which stiffen it. Removes the old coxa,
    tibia and body scripts, which don't fit this design; they get rebuilt next. Removes
    the PCA9685 socket: its wires get soldered.
    fem_check.py now reports foot movement and adds a fall case. Sim masses still
    describe the old layout until the whole leg exists.
2026-11-05 CAD hexapod: femur after the biped's leg_bottom_v2
    A thick plate with a through-hole for each servo and an 8 mm pocket for its tabs,
    4.7 mm of plate under them. The servo bodies hang out bare between 2 end straps,
    which carry the shafts: Ø9 x 1 spacer, Ø8 x 3 shaft, chamfered as on the biped.
    fem_check.py can also run with the servos bonded in, the opposite limit to the
    print alone.
2026-11-05 CAD hexapod: chamfer the femur's edges, FEA pictures
    Every straight edge is chamfered except where a servo must fit. fem_check.py draws
    each case: stress in colour, held faces in blue, loads as red arrows.
2026-11-05 CAD hexapod: femur cable channel, servo lead-ins
    Both servo cables run in a shallow channel on the +Z face, held by alternate fingers;
    the connector comes off, so no big holes. 0.5 mm lead-ins at the tab pocket mouths and
    the ends of the servo holes.
2026-11-05 CAD hexapod: tibia in 2 halves with a trapped presser
    The switch sits inside the tip, button down. A presser trapped between the halves
    rises 0.5 mm under load and pushes it. fem_check.py now handles the tibia too.
2026-11-05 CAD hexapod: coxa link carrying its servo, fork around the femur
    The coxa servo's horn fixes to the body's top plate and a shaft under its floor runs
    in the bottom plate's bearing. No collisions over the femur's +-90 deg. The 3 servo
    cables run in a channel on the plate's +Y face into the body.
2026-11-05 CAD hexapod: triangular tibia, half-sphere foot, stock servo screws
    From the front the tibia narrows from the knee circle to a same-looking circle at the
    tip, with a half-sphere foot on the presser. The halves are joined with the stock 9 mm
    MG90S screws, heads in recesses so enough thread reaches the far half.
2026-11-05 CAD hexapod: body plates, first version
    Bottom plate with the 6 coxa bearing seats, cell seats, board rails and columns; top
    plate with the 6 horn pockets. Known problems, fixed next: rail slots, ESP32 clearance.
2026-11-05 CAD hexapod: battery holder, ESP32 without pins, no cuts in the body
    The cells sit in a flat holder screwed to the bottom plate. The ESP32's pins are
    removed, so it stands in plain rails. Boards at x = 26.6, slid along Y, so the middle
    coxa straps swing in their pin gaps. Rails fit between the pin groups. No collisions
    over +-40 deg of coxa swing and no fit overlaps.
2026-11-05 Sim hexapod: servos in the legs, masses from CAD, 1065 g
    The coxa carries its own servo and the femur carries 2, as in cad/hexapod. Body plates
    and all prints are the CAD's solid-PLA weights. The turn test allows the overshoot this
    weight gives: about -209 deg in 2 s.
2026-11-05 CAD hexapod: curved coxa and tibia, wavy ribbed body, FEA with real PLA data
    The coxa and tibia are now real outlines, not stacked boxes: a horseshoe with an arch
    under it, and a triangle with a round tip matching the half-sphere foot. The body has a
    wavy outline with ribs. Horns get glued, so their screw holes are gone. The FEA uses
    Bambu's PLA Basic figure across the layers (2160 MPa), was checked against a textbook
    cantilever, and now covers the body too. render_views.py draws a part from all sides.
2026-11-05 CAD hexapod: thicker tibia with a round tip, narrower coxa at its axis
    The tibia's bearing arm no longer pinches; its tip is round, matching the half-sphere
    foot, with a round stem hole for a thicker wall. The coxa stays narrow near its axis
    to clear the body's columns. render_views.py now draws parts straight from the geometry,
    with a whole leg at the neutral pose: the foot lands at 69.0, -100.0 mm.
2026-11-05 CAD hexapod: separate body columns, thin ribbed plates, rounded cable groove
    The 8 columns print apart, with a stock screw through each plate into each end. The
    plates are 2.4 mm skins with 2.4 mm ribs, full thickness only around bearings and screws:
    166 g became 130 g. The coxa's cable groove has a rounded floor. Sim at 1115 g.
2026-11-05 CAD hexapod: fix the coxa groove that crashed FreeCAD
    The groove is now one U-shaped outline. A cylinder tangent to a box, plus rounding where
    it met the fork wall, crashed the rounding step.
2026-11-05 CAD hexapod: coxa cable groove clear of the fork arm
    The groove's end cut 1.7 mm into the root of the +Y fork arm, the link's highest stress.
    It now starts past the tab pocket and leaves through the fork wall beside the arm.
2026-11-05 Sim hexapod: terrain map drift at 1120 g marked as a known failure
    The map floor drifts 9.4 mm in 40 s at the CAD's weight, levelling off at 13.1 mm.
    It depends on the mass: 3.6 mm at 815 g, 4.5 mm at 900 g.
2026-11-05 CAD hexapod: joints centred on the leg plane, mirror-image tibia halves
    Each femur and tibia servo sits 4 mm toward its horn, so the whole joint, not the servo,
    is centred on the leg plane. The tibia halves and the coxa's fork arms are now mirror
    images at +-22.5 mm. The femur print is unchanged, only placed 4 mm off-centre. Joint
    axes, link lengths and the foot don't move.
2026-11-05 CAD hexapod: ToF mount on the top plate, power switch, deeper board slots
    The VL53L5CX boards at z 2 hit the front coxa links at every angle, so they
    move onto a separate mount screwed to the top plate's front (z 22 in
    TOF_SENSORS; x, y and angles unchanged). A KCD11 rocker snaps into the top
    plate at the rear. The standing boards slide into 6 mm slots (3.5 under the
    ESP32's module). Legs block at most 2.7 % of the ToF zones on average at full
    speed, 12 of 64 at worst (a fast turn); the mount and plates block none.
2026-11-05 CAD hexapod: room around the PCA9685 nodes
    Boards 0.8 mm further out (Mini360 1.0 mm from the cells, was 0.19), side
    columns 0.5 mm further along Y (pins 1.1 mm away, was 0.59), and the bottom
    plate's border rib notched behind the pin groups.
2026-11-05 CAD hexapod: measured KCD1 power switch and Mini360 stack
    The switch is a KCD1 (LY601), 18.18 x 12.49 body, 2 pins; its cutout moves to
    y -48. The Mini360 stands 4 mm off the PCA9685 (pad + PCB + inductor), so it
    is now 2.0 mm from the cells.
2026-11-05 CAD hexapod: render of the whole robot at the neutral pose
2026-11-05 CAD hexapod: assembled-frame FEA, thicker femur plate, wider slots
    fem_check.py CASE frame: both plates, the 8 columns and the 6 coxa links with
    servos, horns and bearings, joined. Tripod walk and twist peak ~6.7 MPa, 0.34
    mm; landing on one front leg 23 MPa at that coxa, plates under ~3 MPa.
    Femur plate 4.7 -> 6.5 mm: the bridge between its servos was over the PLA
    limit landing on one leg (99.9 % 23.9 -> 18.5 MPa print alone, 17.1 bonded;
    the rest are point loads at the screw pilots). Femur 20.1 g. The coxa keeps
    its own 4.7 mm plate.
    Board slots 0.3 mm per side, switch cutout 0.25: printed PLA swells.
    Sim masses synced: 1132 g.
2026-11-05 CAD hexapod: battery cartridge, in from below
    The holder rides in a printed cartridge (14.8 g) whose floor fills an opening
    in the bottom plate, flush with its underside. Two turn latches (stock-screw
    pivots) hold it; turned 90 deg it drops straight out (checked for 45 mm). A
    blind-mate XT30 connects it: the male on a tongue behind the holder, the
    female on a bridge from the bottom plate. Holder moved to y -8, the power
    switch to y -40.
    Frame FEA with the weight on the latches: walk 7.8 MPa peak at a latch
    pivot, 99.9 % under 2.0, 0.21 mm.
    Sim: 1139 g, cells at y -8. The 30 mm step test now takes the median of 3
    seeds: one stumble on the edge costs ~130 mm by chance (seed 3 failed at the
    o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
2026-11-05 CAD hexapod: battery XT30 on a lead, unplugged by hand
    A blind-mate XT30 would put its 20-40 N plug and pull force through printed
    parts and glue at every swap (40 N FEA: the bridge over the female peaked at
    48 MPa). Now the pair lies on the right cell, strapped to the holder; the
    cartridge comes down with it on the lead and the pair is unplugged by hand.
    No tongue or bridge: the opening is 43.9 x 85.4, two latches front and rear.
    build_body.py also clears Battery_* parts on a rebuild (they piled up as
    renamed copies that the checks didn't see).
    Frame FEA: walk 7.8 MPa peak at a latch, 99.9 % under 2.0, 0.21 mm.
    Sim: 1137 g.
2026-11-05 CAD hexapod: pocketed body plates, tube columns
    Both plates are full thickness only under ribs, bosses, rings, rails and the
    battery band (plus 1 mm), elsewhere a skin with a 22 mm diagonal rib grid:
    top 0.8 mm skin (on the bed, pockets open inside), bottom 1.2 mm with a flat
    underside on the bed (its bosses used to hang 1.6 mm under the skin).
    Columns are tubes between their screw pilots.
    Top 57.0 -> 46.3 g, bottom 39.5 -> 40.1 g, columns 23.0 -> 17.5 g: -15.6 g.
    Frame FEA walk: 99.9 % under 3.3 MPa (was 2.0), 0.26 mm (was 0.21).
    Sim 1122 g.
2026-11-06 CAD hexapod: pockets in the coxa's solid sides
    The sides next to the coxa servo were ~8 mm solid with almost no stress.
    Pockets open from below (2 mm walls to the servo and outside, 2 mm roof)
    take the coxa from 35.1 to 32.2 g. FEA landing, servos bonded: 99.9 % under
    9.2 MPa (was 9.7), foot 1.65 mm (was 1.54); the 46 MPa peak is the servo's
    far corner, a sharp point that didn't move when the pockets were shortened.
    The tibia has nothing left to cut: its arms are the horn pocket and roof.
    Sim 1104 g. The 30 mm step test now judges 6 seeds (median distance > 550,
    mean tilt, median reach rejects < 650): single seeds swing 461-627 mm and
    437-704 rejects at the old mass too.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
2026-11-06 CAD hexapod: measured battery holder, ESP32, PCA9685 pins, switch bezel
    Holder 77.19 x 39.77, holes 55.46 apart (average of 58.57 outer and 52.34
    inner edges); ESP32 PCB 1.64, module 3.2; PCA9685 bent pins 8.5 high;
    switch bezel 14.93 x 20.9, clips 19.13 along the long side. All fits clean.
2026-11-06 CAD hexapod: measured foot switch (5.98 square, 3.39 body, 4.03 with button)
2026-11-06 CAD hexapod: measured MG90S and horn, ToF at z 23
    Horn: hub 7.24 x 5.15 (the old 4 mm recess left it 1.15 mm proud of every
    pocket), arm 2.02 thick, 18.3 from the shaft to the tip. MG90S: body 12.15 x
    23.16, tabs 32.39, turret top 28.64, spline tip 31.89, horn face 34.04 (the
    joint stack is now that measured value). Every joint is ~1 mm wider; the top
    plate sits 1 mm higher, so TOF_SENSORS z 22 -> 23.
    Weights: coxa 33.1, tibia 16.1, top plate 48.9; sim 1119 g. FEA landing:
    femur 99.9 % under 18.6 alone / 16.5 bonded, coxa 8.7, tibia 4.7 MPa. All
    fits and sweeps clean.
2026-11-06 CAD hexapod: MG90S tabs 17.54 above the body bottom, turret as wide as the servo
    Every servo sits 0.54 mm deeper in its link; the joint stack (34.04 to the
    horn face) and the ToF height don't change. Femur 20.3 g, coxa 33.3 g, sim
    1121 g. FEA landing: femur 18.4 alone / 16.6 bonded, coxa 8.7 MPa (99.9 %).
2026-11-06 CAD hexapod: fit test print, clearance in the horn pockets
    build_fittest.py exports print/fit_test.stl (12.6 g): the MG90S pocket with
    its screw pilots and lead-ins, a horn pocket, a bearing seat and a shaft, a
    column screw pilot with its plate, the two board slots, and the switch
    cutout, all from the same Params as the real parts.
    The horn pockets had no clearance (exact hub and arm size): now 0.15 mm a
    side and in depth, for glue (horn_fit).
2026-11-06 CAD hexapod: fit test packed into a 79 x 70 mm block, centred
2026-11-06 CAD hexapod: model re-saved before a restart (no changes)
2026-11-06 CAD hexapod: fit test results, flattened tapered horn, ToF at z 22
    From the first fit test print:
    - board slots 0.05 mm a side (0.3 printed true to size and was loose),
    PCA9685 board 1.6
    - stock screw clearance 2.5; visible heads in 5.6 x 1.4 counterbores; the
    columns stop 1 mm under the top plate so there is plate under the head
    - switch cutout 19.15 x 13.35 (the print came out 0.24 x 0.15 small)
    - 10 mm hole under every bearing seat, to push the bearing out
    - horn: the arm tapers from the 7.24 hub to a 4.7 tip (small_dog Sketch062
    has the same shape), shared by every pocket (common.horn_pocket); the horn
    is flattened to 3.8 by the user, so every joint is 1.35 narrower and the
    top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
2026-11-06 CAD hexapod: lead-in chamfers on the fit test
    common.lead_ins chamfers the convex edges only (hole and pocket mouths,
    outlines; never inside corners like a pocket floor): 0.2 on holes up to 3.2
    (screw pilots and clearance holes), 0.4 on everything else.
2026-11-06 CAD hexapod: lead-in chamfers on the model
    common.lead_ins on every part after its rounding: 0.2 on holes up to 3.2,
    0.4 on other convex edges (never inside corners: the removed volume is
    checked, it must not grow). Femur servo openings 0.5 -> 0.4. Kept sharp: the
    tibia's split face (but its screw holes get theirs), the femur's and
    coxa's shafts and spacers (the spacer face bears on the bearing's inner
    ring). On the plates only the fit openings get them: bearing seats and push
    holes, horn pockets, column sockets and screw holes, switch cutout, battery
    opening, latch pilots, board slots. The kernel refuses some edges where they
    run into rounded surfaces; those are counted in the build output.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
2026-11-06 CAD hexapod: second fit test results
    - servo pocket 0.15 a side across the servo (0.2 along it)
    - bearing seat 12.3 (12.2 was too tight in this print, fine in the last)
    - shafts 2.6 long (0.4 shorter)
    - PCA9685 board 1.55: its slot gap 1.65
    - switch cutout short side 11.8 (the switch is ~11.6 and only clips on the
    long side); switch dummy 11.6 wide
    Horn pocket, column and screw plate, ESP32 slot unchanged (right).
2026-11-06 CAD hexapod: fit test prints only what still needs trying
    Approved pieces (horn pocket, column, screw plate, ESP32 slot) are listed in
    APPROVED and left out of the STL (ALL=True puts them back); the board slots
    are one piece each. Now: servo pocket, bearing seat, shaft, PCA9685 slot,
    switch panel, 64 x 51 mm, 8 g.
2026-11-06 CAD hexapod: tibia joined by 2 diagonal screws; servo fit test in its own file
    The tibia's 4 screws and their head recesses crowded the tip: now one at the
    lower position on +x and one at the upper on -x. Halves 7.1 + 7.7 g, landing
    FEA 99.9 % under 8.0 MPa.
    The fit test's servo pocket goes to print/fit_test_servo.stl (SEPARATE), the
    rest stays in fit_test.stl.
2026-11-06 Foot contact switches on ESP32 GPIO pins
    FootSwitches (lib/robot_core) debounces one switch per leg over N motion
    ticks; feet.cpp reads FOOT_SWITCH_PINS with internal pull-ups every tick
    and feeds legs[].sensor.onGround while the gait uses them. CLI
    `feet on|off|state` (applied while standing, like gait changes).
    Hexapod default pins 16 17 18 19 23 25; other models have none.
    Claude-Session: https://claude.ai/code/session_01L7WAAD8HErrnJjTafkg9mv
2026-11-06 CAD hexapod: clear way in for the horns; fit test down to the servo pocket
    The top plate's ribs hung below the horn pockets and crossed some of their
    outlines: in place nothing overlapped, but the horn could not come up into
    its pocket. The pocket is now one cut from the ribs' underside up to its
    roof, and build_body checks every horn rising 12 mm into place (clear).
    Fit test 3: bearing seat, shaft, switch panel perfect, PCA9685 slot good:
    all approved, fit_test.stl removed; fit_test_servo.stl is all that's left.
    Frame FEA: the glued horn is modelled as its pocket's shape (grown 0.5 over
    the lead-ins), not the straight-armed dummy; it still meshes into inverted
    elements around the horn cha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
2026-11-06 CAD hexapod: fit test complete, servo pocket approved too
    Every piece is approved in a printed test; no fit test STL is left.
2026-11-06 Hardware in the loop: real ESP32 brain, MuJoCo body over USB serial
    The robot-dog-hil / robot-hexapod-hil envs build the whole firmware for a
    bare ESP32 (motion task, WiFi AP, web UI, CLI, failsafe, battery, ToF map
    and nav) with the devices swapped for ones that talk to the PC:
    - lib/robot_core hil_link: framed protocol (sync, type, length, CRC-16),
    servo pulses + tick dt out, accel/gyro/mag/feet/battery, ToF frames and
    PC move commands in. Native Unity test.
    - hardware.h: TofArray and FootInput interfaces; the VL53L5CX driver and
    the GPIO foot switches now sit behind them.
    - hil.cpp: HIL servo bus, ToF array, foot input, link + CLI `hil`;
    sensors.cpp: HIL IMU (same TiltEstimator /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
2026-11-06 CAD hexapod: INA219 power sensor at the rear
    The firmware's INA219 (POWER_SENSOR, 0x41) gets a place: the common purple
    module, pins off, standing along Y behind the battery opening at x -6.5,
    next to the switch and the XT30 lead. A slot through the bottom plate's rear
    rib and 2 short slot pairs hold it; on its component side only a 1.8 mm lip.
    Sizes are the typical seller ones, marked TODO measure. All fits, the leg
    sweeps and the cartridge's way out stay clear. Sim +2 g: 1105 g.
2026-11-06 CAD hexapod: plan_map.py, a top-down map between the plates
    Where the coxa links and their servos swing (+-40 deg, sliced and turned in
    2D), the electronics, and the room an inner wall around them could take;
    prints what pokes out. Draws views/tub_plan.png.
2026-11-07 CAD hexapod: inner wall around the electronics (0.8 mm, separate print, cable slots); INA219 to the front
2026-11-07 CAD hexapod: export_stl.py, leg parts as STL into stl/ (ignored)
2026-11-07 CAD hexapod: tibia tip after print 1, the switch on real ledges, presser slides
    The ledge under the switch was 0.24 mm (not printed) and the presser had 0.1 a side.
    Stem 4 mm in a 4.5 hole so the switch sits on 0.74 mm ledges, 0.25 a side wherever
    the presser slides, 0.3 gap to the button, 0.35 press then the flange stops on the
    plastic, dome clear of the shank over the whole travel. tip_section.py draws it.
2026-11-07 CAD hexapod: femur cable fingers become full bridges, 8 x 2.4 (print 1: fingers broke off)
2026-11-08 CAD hexapod: foot switch and presser copied from the old (gear) hexapod
    The tip redesigns kept failing in print, so the old tibia's switch pocket, lead slots,
    button ledges and the pin that holds the presser are taken as they are from its
    finished halves (import_old_tip.py -> old_tip/voids.brep) and cut into the new tip, and
    its TibiaTip is the presser (old_tip/presser.brep). Foot radius 4 (sim too); the lower
    half screw moves up to -37.5, clear of the lead slots.
2026-11-08 CAD hexapod: coxa bearing arm screws on, so the femur can go into the fork
    The one-piece fork couldn't take the femur (spline and shaft both point outward). The -Y
    arm with the bearing is its own print from x 28, held by 2 stock screws on a diagonal like
    the tibia halves; the hollow stops 5.5 mm behind the joint so they bite into solid.
    Coxa_Body + Coxa_Arm print, Coxa_Main is both for the checks, body and FEA.
2026-11-08 CAD hexapod: tibia tip, one lead slot (not by the screw), 6 mm foot on the old presser
    tip_section.py now draws the foot hanging (slot on the pin) and pressed (up to the first
    contact) and measures the button: the presser's foot meets the shank's end 0.11 before
    it reaches the button, as in the old file.
2026-11-08 CAD hexapod: STL export lays split parts on their split face
2026-11-08 CAD hexapod: tibia tip, the tongue over the switch blends into the body on the +X side
2026-11-08 CAD hexapod: tmp_tibia_tip_test.stl, the tibia's tip halves alone to try the switch first
2026-11-08 CAD hexapod: tibia tip test as 3 STLs (both halves, presser)
2026-11-08 CAD hexapod: alignment pins on the tibia halves and the coxa's bearing arm
    As in the old tibia: 2 x 1 mm pins on one side of the split (the tibia's bearing half,
    the coxa body), holes in the other. Holes 2.3 x 1.3 (0.15 a side, the pin never bottoms)
    with a 0.4 lead-in. Sites checked solid in both parts, diagonal to the screws.
2026-11-08 CAD hexapod: VL53L5CX measured; ToF mount pocket for its back parts
    Board 15.87 x 10 x 1.49, holes 2.94 at 19.7, ears 5.17, cover 11.9 x 7.28 base and
    10.35 x 5.66 top, 3.57 high, 3.5 from the pin edge (sensor 2.14 off the board's centre),
    1.2 of parts on the back: the mount gets a pocket for them, the board sits on its ears.
    lead_ins now refuses a chamfer that grows the shape (it had added a stray sheet to the mount).
2026-11-08 CAD hexapod: tibia tip pockets 0.2 a side wider across (the copied ones had 0.01-0.1)
2026-11-08 CAD hexapod: presser foot 0.5 lower on a longer stem (print 2 stuck): stops on its pin now
2026-11-08 CAD hexapod: coxa horn pocket open past the fork's crotch; chamfers on the shaft
    The femur horn's arm reached under the fork's crotch (x 41.6 to 49): a closed
    tunnel, so the horn couldn't go in. Its outline now goes one pocket-depth
    further into the crotch, so the horn slides in from the fork's open end and
    then sideways into its pocket (path checked, 0 overlap). The shaft's tip gets
    a 0.4 lead-in; the spacer's outer edge gets 0.2, so it still bears on the
    bearing's inner ring. Coxa FEA: fall, bonded 99.9 % under 9.2 MPa (was 9.6).
2026-11-08 CAD hexapod: solid coxa, slim around its servo; sim masses and r6 feet
    The coxa had a hollow under its top and two pockets beside the servo, open
    from below: overhangs that needed supports. They are gone (the slicer's infill
    does that job); instead the outline is a 3 mm wall around the servo and its
    tabs, widening from x 4 to the fork. 35.7 g solid (was 32.5 with the pockets).
    Landing FEA: 99.9 % under 15.9 MPa with the servo on its screws only (2.4 mm
    walls gave 17.7, over the 17.5 limit), 10.7 bonded; twist 5.0 / 4.5.
    Body checks clear (coxa sweep, plates, cartridge); inner wall 15.0 g.
    Sim: coxa 45.3, femur 47.9, tibia 17.1 g per leg (prints 31.9, 21.1,
    15.1 in simple_parts too), 1110 g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
2026-11-08 CAD hexapod: coxa flat on the bearing arm's joint plane, arm a flat plate
    Nothing of the coxa is left past the joint plane, so it prints on that face
    with no supports; the bearing arm is a flat plate from x 28 (square front,
    rounded outer corner) and prints on its outer face. The alignment pins moved
    to the arm, the holes into the coxa. The coxa's side above the plane is
    unchanged. Export lays both on those faces.
    FEA landing: 99.9 % under 15.2 MPa servo on its screws, 10.3 bonded;
    twist 8.5 / 4.3. Body checks clear.
    Sim: the coxa mass now counts its bearing arm (35.6 g print): 1132 g in all.
2026-11-08 CAD hexapod: presser 0.15 a side thicker in Y, 0.25 in X (it wobbled in the tibia): 0.15 a side left
2026-11-08 CAD hexapod: STLs placed on the bed by their mesh, not the shape's loose BoundBox (the coxa floated 2.7 mm)
2026-11-08 CAD hexapod: coxa bearing side cut off next to the servo (y -9.2) from x 26, a flat plate
    The coxa keeps its smooth flare in front of the cut and prints on its +Y face; the bearing
    side is a square plate printed on its outer face, pins up. Landing FEA 14.9 MPa alone (was
    15.2), twist 4.7 (was 8.5); without the flare it went to 18.2, over the limit.
    Body: the coxas' swing outlines are fused two at a time: the mirrored middle coxa's one-go
    fuse lost its outline and the inner wall ran through it. Sim coxa 48.9 g.
2026-11-08 CAD hexapod: leg cables checked through every joint; femur holds the foot switch lead
    - femur: a channel with 3 bridges on the -Z face for the foot switch lead, from under the knee
    axis to the gap between the servos; the +Z channel 1.4 deeper (lead on the servo cables) and
    from x -4 (from -9 its deeper hip bridge hit the coxa at femur -45..-75)
    - coxa: groove 1.4 deeper (5.6 clear under the bridges for 2 servo cables + the lead) and it
    ramps up out of the top face at x 41 instead of running through the fork wall, where the
    femur's tail passed 0.5..3.5 mm from its mouth at every angle; bridges moved in
    - body: wall slot floor 1 mm over the coxa's top, so cables leave over the coxa, no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
2026-11-08 Sim hexapod: looks like the CAD (meshes from cad/hexapod), boxes keep the masses
    - cad/hexapod/export_sim_meshes.py writes each sim link's CAD parts into
    sim/models/meshes/hexapod/ in that link's frame (torso plates, its parts, coxa + servo,
    femur + servos, tibia halves, presser; the left legs mirrored), 2.7 MB decimated
    - mjcf.py shows them (class "look", no mass); the simple_parts boxes keep the masses and
    move to geom group 4 when the meshes are there, so the physics is unchanged (1144.1 g)
    - README: new standing / walking pictures, lidar navigation and obstacle course
    - tests: 86 passed, 1 xfailed
2026-11-08 Sim README: hexapod navigation picture with its ToF sensors (no lidar on it)
2026-11-09 CAD hexapod coxa, print 1 feedback: bearing side flush with the coxa, screw heads 2 mm over the joint (7 mm pilots), a cable hole through the coxa in place of the groove and its bridges; sim coxa 50.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
2026-11-09 CAD hexapod body: cables up through the bottom plate; PCA9685 boards turned over (connectors plug in from below), no inner wall
    A cable slot (10.5 x 9.6) through the bottom plate under each pin group; the room the connectors and
    their cables need is checked against the plates, rails, columns and the coxa sweep. The middle board
    rail only on the pin side (the Mini360s hang low now), pca_y +6.1 so the middle coxa still swings in
    the pins' gap, coxa rear corners r 6 (0.44 mm from the pins at worst). Sim: body 123.5 g of prints,
    coxa 36.8, robot 1149 g.
2026-11-09 CAD hexapod femur, cleaner: 2 cable bridges on top (no middle one), a short tube under the knee for the switch lead in place of the -Z channel
    The lead runs from the tube along the side to the gap and up into the top channel. Femur 21.2 g
    (was 23.0); fall FEA 99.9% 16.6 / 16.7 MPa alone / bonded (was 15.6 / 16.4: the -Z rails stiffened
    the bottom edge). Lead-ins now refuse a chamfer that takes more than 10% of a part: one gave the
    femur a negative volume that still said valid. Sim: femur 48.0 g, robot 1138 g.
2026-11-09 CAD hexapod femur: the switch lead's tube upright on the knee end (past the knee axis), nothing under the femur
    The lead comes up from the tibia's fork through it and back along the +Z edge into the channel.
    Its loop at the knee is longer now, 31 mm (the tube is 15 mm from the knee axis; it was under it).
    Femur fall FEA 99.9% 16.8 / 16.7 MPa alone / bonded.
2026-11-09 CAD hexapod femur: the switch lead's tube thicker (2.4 wall) and blended into the knee end with 3 mm fillets
2026-11-09 STLs for the body parts too (plates on their skins, columns, ToF mount, cartridge, latches); hexapod step test: distance within 5% of blind
    The blind run makes 567 mm whatever the seed; the 6 seeing runs spread 466-628 around it, so their
    median beat it at 1138 g and missed by 9 mm at 1139 g. They still climb level (tilt 2.2 against 4.1).
2026-11-10 CAD hexapod coxa: the flare stays (without it the landing FEA went over, 18.9 MPa), its top edge rounded 1.5 and the step under it a slope
    Tried and dropped: a flat bearing side rising at 45 deg (18.9 MPa alone), the same with a 3 mm thicker
    wall (18.8), and a deeper arch under the far tab (the kernel crashed rounding it). FEA now 14.0 / 9.8
    MPa alone / bonded. Sim coxa 50.1 g, robot 1138 g.
2026-11-10 CAD hexapod coxa: symmetric from above (the bearing side curves out like the horn side, no flare) and a keel underneath
    Seen from the fork end the underside tapers from the fork arms (y +-22.3, z -9.1) to the floor's width
    (+-9.2) at its bottom, both sides alike. The bearing side's outer face follows the curve from x 26 to
    36, so that bit of it lifts off the bed. FEA 14.2 / 9.3 MPa fall, 4.4 / 3.9 twist (alone / bonded);
    coxa 34.6 g; sweeps clear, pins 0.44 mm. Sim robot 1126 g.
2026-11-13 CAD hexapod joints, print 1 measurements: horn 4.1 thick (servo + horn 33.0), 1.8 mm under the femur's servos for their cables
    The cable comes out at the bottom of the servo and lifted it 1.25 mm off a 0.5 mm gap: the femur
    measured 38.25 across the hip joint against 37.19, and the coxa's bearing side would not close. The
    coxa keeps 0.5 (its servo's cable leaves through the opening under it). The top plate keeps its
    printed horn pockets (3.8 deep; the horn sticks out 0.3 below): the plates are the same prints, the
    top one 0.3 higher, on 0.3 longer columns. Fork gap 34.19, femur across the joint 38.79. FEA coxa
    14.1 / 8.9, femur 16.6 / 16.6 MPa fall. Sim robot 1135 g.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
2026-11-13 CAD hexapod coxa: 1.3 mm under its servo for the cable too, and a slot through the floor at the servo's far end
    The cable comes out at the bottom of the shaft end, runs under the servo and drops out at the far end
    (print 1: trapped the same as in the femur). The coxa's servo and everything above its floor sit 1.3
    higher; the top plate is the same print 1.6 higher on 1.6 longer columns (37.4), the bottom plate
    unchanged. Coxa FEA 13.8 / 9.3 MPa fall. Sim robot 1140 g.
